mtongnz/ESP8266_ArtNetNode_v2/schematics/convert_max485_to_pix.png

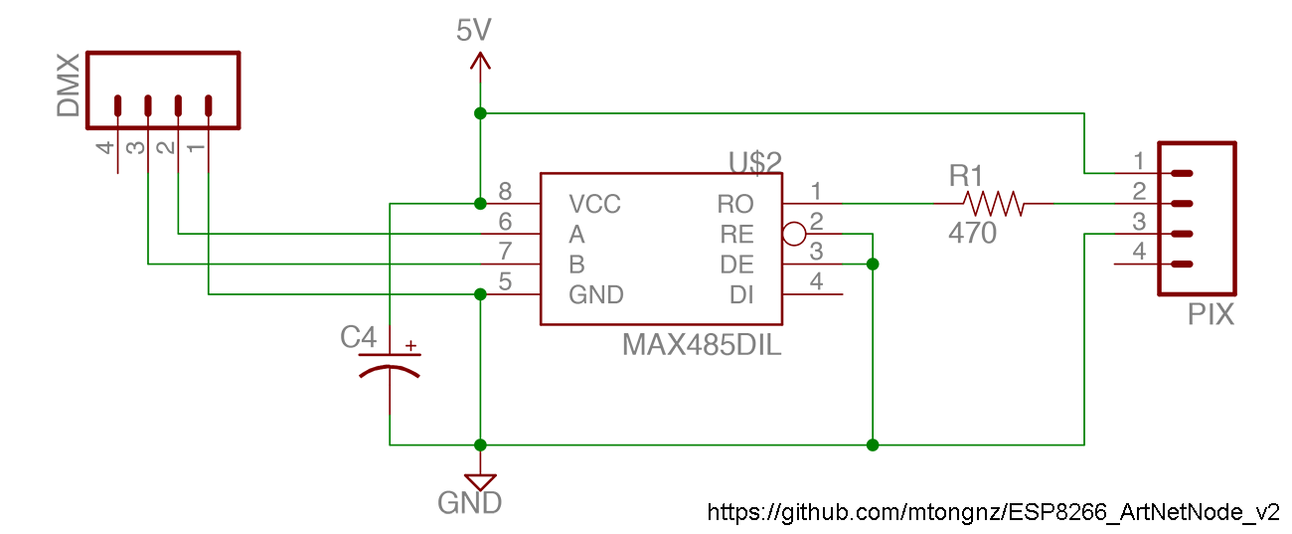
schematics/convert_max485_to_pix.png
