mtongnz/ESP8266_ArtNetNode_v2/schematics/esp_Artnet_RDM_isolated_v2.jpg

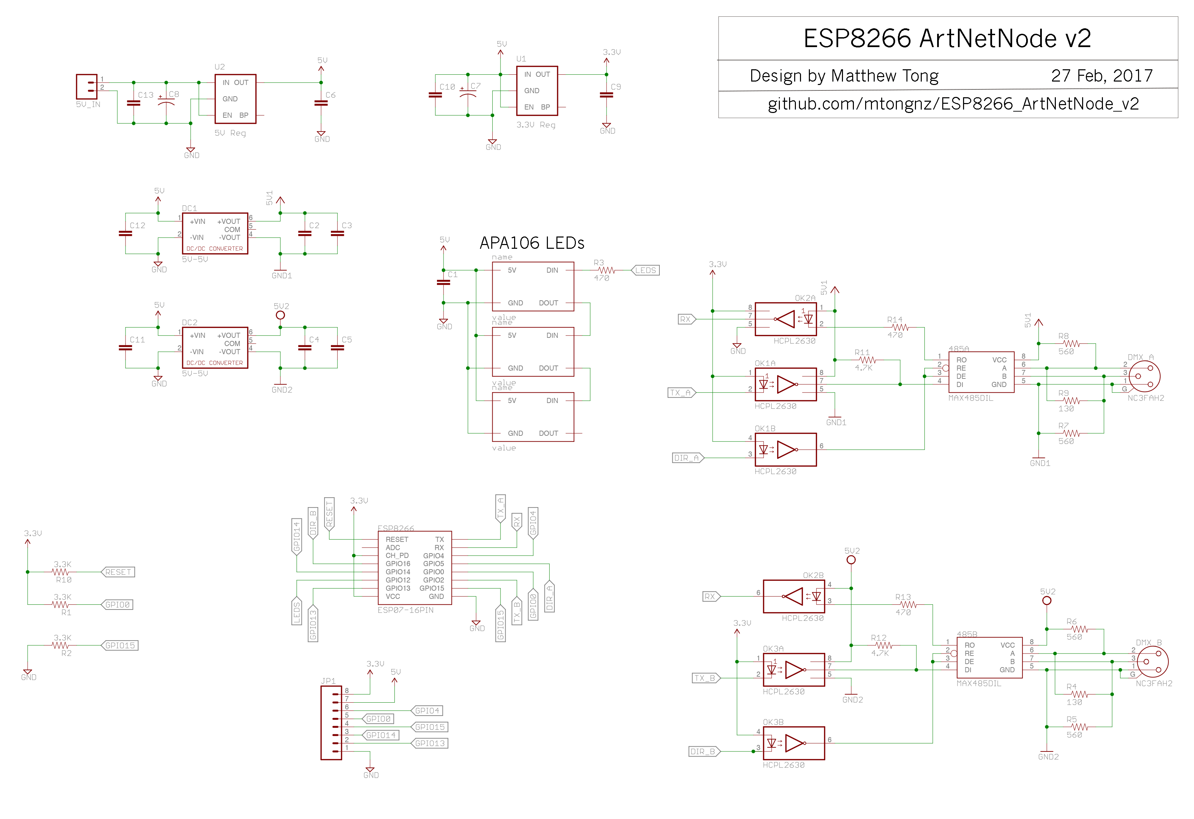
schematics/esp_Artnet_RDM_isolated_v2.jpg
