mtongnz/ESP8266_ArtNetNode_v2/schematics/node_dmx_and_pix_v2.png

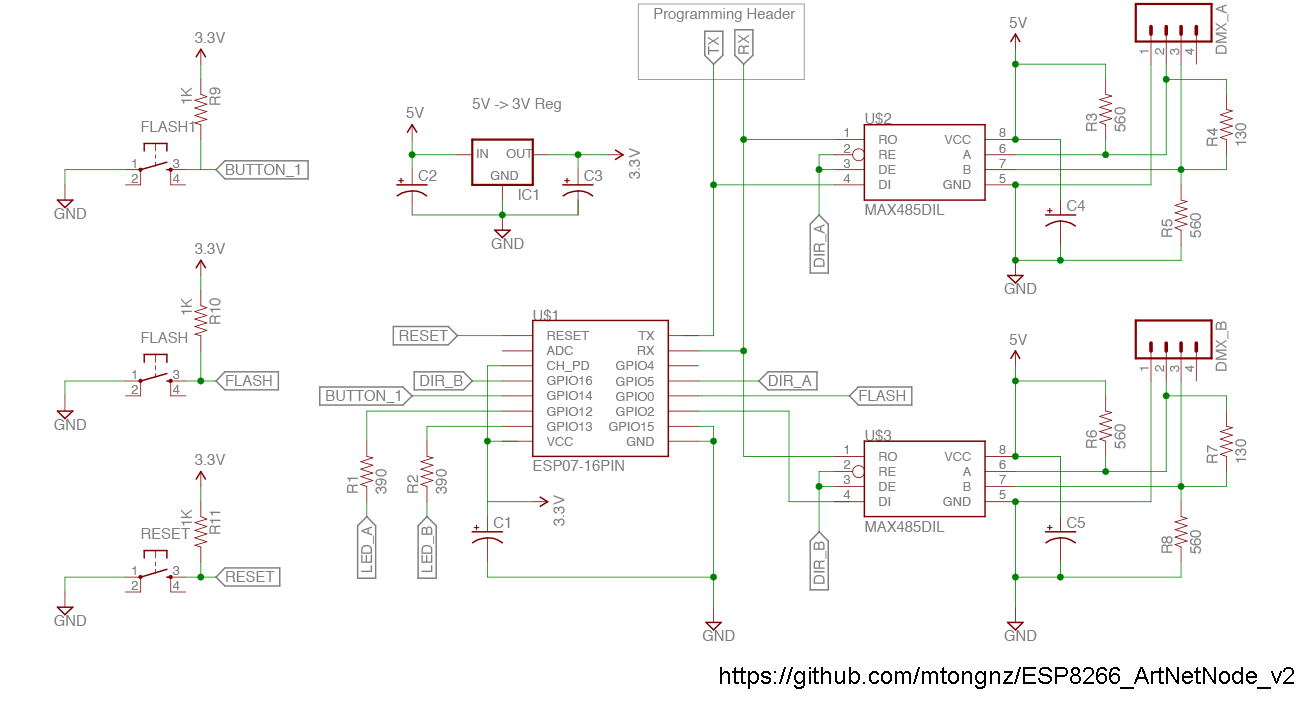
schematics/node_dmx_and_pix_v2.png
