mtongnz/ESP8266_ArtNetNode_v2/schematics/node_pix_only_v2.png

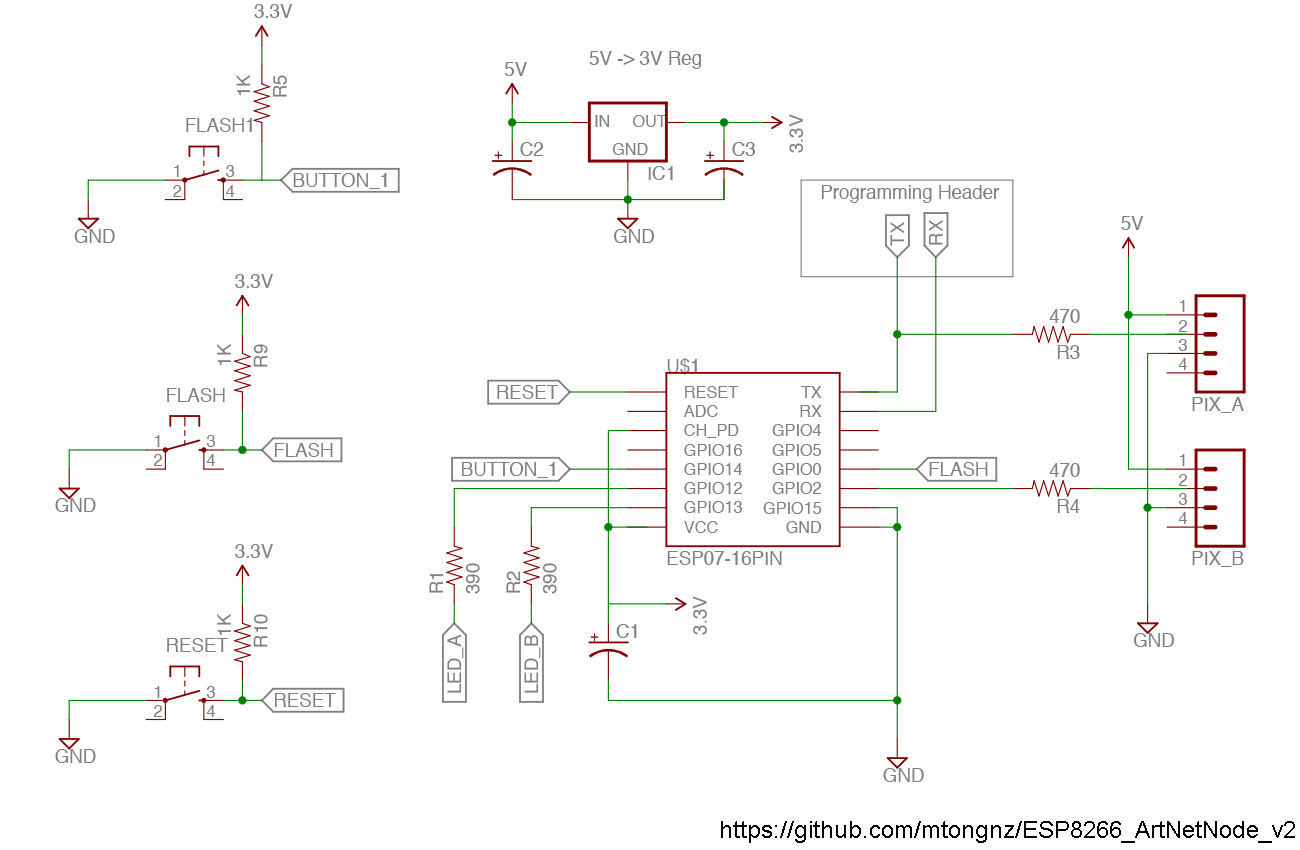
schematics/node_pix_only_v2.png
