mtongnz/ESP8266_ArtNetNode_v2/(threads)

Thread 1 (2017-02-01):

RDM Stops after discovery

mtongnz, 2017-02-01:
I've found an issue where the RDM stops during or after discovery if DMX is present.

The cause of this appears to be a faulty timer interrupt.  I'll hopefully have it fixed shortly.

mtongnz, 2017-02-01:
Hopefully this is now fixed.  Let me know

mtongnz, 2017-02-03:
beta1c should fix this issue

Closed 2017-02-08.

Thread 3 (2017-02-01):

Occasional reboot ~10 seconds after start

mtongnz, 2017-02-01:
Normally sorts itself out after a second boot.

I have put a temporary fix of forcing the device to boot a second time.  This isn't ideal and wastes about 5-10 seconds but it seems to fix the issue.

mtongnz, 2017-02-03:
beta1c should fix this issue

Closed 2017-02-08.

Thread 6 (2017-02-01):

RDM issues when DMX data sent

mtongnz, 2017-02-01:
It seems that DMX Workshop loses its RDM data when artDMX is sent to the device.

I think this may be because I am broadcasting RDM replies.  I will try unicasting the replies to see if it fixes the issue.

mtongnz, 2017-02-03:
beta1c should fix this issue

Closed 2017-02-08.

Thread 8 (2017-02-04):

Feature request: ad-hoc

irpyc, 2017-02-04:
Hey Matt,

First of all, really great job!

For my use, which is more mobile (shootings), I'll love if it was possible to use it without the need of establishing a network first, and use it directly with a DMX/Artnet soft on a tablet.
Even using one device as AP with the others connecting to it seems not so reliable, since if the AP disconnect (like running out off battery), all the others will then start a network at the same time.

Do you think there is any way to use Artnet on ad-hoc mesh such this project does?
(working version) https://github.com/sfranzyshen/easyMesh
(original and dependencies) https://github.com/Coopdis
(new fork of it) https://gitlab.com/BlackEdder/painlessMesh/

This would simplify a lot the deployment, and even extend the range.
So I'm not sure if it's at all possible, my programming and networking skills are way to low...
This easymesh project use TCP while Artnet seems to use UDP (on top of TCP ?). And easymesh doesn't use the Arduino libraries, so I guess they will be no native UDP support in it.
Maybe the fact that all the node get the same IP adress could be a problem somehow, but if only one node send the "sendArtNetReply", and then all of them get the same Artnet signal back, why should it not work?

What do you think?
Thanks,
Kind regards

mtongnz, 2017-02-04:
The mesh network idea is a good one but I fear it would be extremely hard to implement and I don't know how good the performance would be. I haven't done any mesh networking with the esp yet.
As for using one device as an AP with other devices connected, this doesn't work due to a limitation in the esp core files which doesn't allow packets to be forwarded properly from one client to another. I haven't tried it with this project but spent weeks trying to get it to work on another one before giving up.
The devices shouldn't start a network when they disconnect unless you restart them. I will be making it so each unit had a unique ssid soon and also adding the ability to change the hotspot name and password.
How have you found the stability and performance a far? And do you have RDM fixtures? If so, is the RDM working as expected?
Thanks heaps for the feedback. Id's much appreciated

Thread 15 (2017-02-08):

WS2812 not working properly

mtongnz, 2017-02-08:
I've found that the ws2812 doesn't work properly when using different power supplies for the ESP and the pixel strip.

Try running the device with the same 5V supply you use for your strips.  Obviously don't put 5V direct into the ESP - use a 3.3V reg to drop it down.

This seems to only be an issue with a larger number of pixels.

Please leave some feedback if you experience this

mtongnz, 2017-02-11:
Currently testing some new timing at a slower rate.  If it works, I'll add an option to the web UI so you can have the fast aggressive timing or the slow stable timing.

It seems to only be an issue with longer strings of pixels

nanu-c, 2017-02-12:
I think the solution for that is in experience to connect the - pol of the two power supplies.
The ws2812 is really sensible in that case.
And other thing i experienced with long strips is the voltage drop on the signal channel. You can use pull-up resistors to solve that or don't use more than 1m of cable in between the end of the last stripe and the first of the next stripe...

mtongnz, 2017-02-12:
beta4a has slightly slower data rates to try to help with this.  Initial tests seem to show good results

kaeltaz, 2017-02-14:
Try this timing
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

mtongnz, 2017-02-19:
Beta5 has much more strict timings in use.

It's working flawlessly on my 150 pixels - a few more are on the slow boat from China thanks to a couple of generous donations I received.

Try it and let me know.

mtongnz, 2017-02-26:
#36 is the same issue as this.  I am closing this thread and we can discuss there

Closed 2017-02-26.

Thread 17 (2017-02-09):

First pix on 2 uni is blinking

kaeltaz, 2017-02-09:
First pix on 2 uni is blinking

https://www.youtube.com/watch?v=qbqkvZ2hWWU

mtongnz, 2017-02-11:
I believe this is related to this issue: #15

I am waiting on some new pixels to arrive (bought thanks to a couple of donations I've received) before I can fully test my fix.  At present I only have 150 pixels to test with :(

mtongnz, 2017-02-12:
I've released beta4a.  It has a slightly slower data rate which will hopefully fix this issue.  Please try and let me know

Alfiszcze, 2017-02-17:
I belive that it is universe problem because the same issue is with 1st pix on 3rd universe .
512 dmx /3 = 170 and leftover 2 slots from dmx universe.

mtongnz, 2017-02-19:
Please try beta5 and see if it's better

mtongnz, 2017-02-21:
OK.... I've actually found the cause of this.  It was nothing to do with timing - I was accidentally writing over the first 2 channels of uni 2 with channels 511 & 512 of the first uni.

beta5a should definitely fix this issue.  I've only got 150 pixels so please test and let me know.

Closed 2017-02-26.

Thread 21 (2017-02-12):

Feature request: Reset Esp01

kaeltaz, 2017-02-12:
Reset esp-01 turning it on 5 times for 5 seconds.

mtongnz, 2017-02-16:
This will be in beta5.  Just doing more tests on it before release.  Having issues with DMX output interfering with the LED pixel timings

mtongnz, 2017-02-19:
Now in beta 5.

Allow the esp8266 about 1-4 seconds to start, then reset it (or power cycle).  Do this at least 5 times to restore factory default settings.

Closed 2017-02-20.

Thread 22 (2017-02-13):

Web Ui

kaeltaz, 2017-02-13:
My suggestion on web ui

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

mtongnz, 2017-02-13:
Ability to add and select custom themes will be added once I implement SPIFFS for storing scenes

kaeltaz, 2017-02-13:
I thought about the main themes

mtongnz, 2017-02-27:
You can now upload your own themes to the device in beta5c.  Goto /style to upload a new theme or revert to the default.

If anyone comes up with some good themes, please send them to me.  I'd love to have a look

Wachenanggo, 2023-01-02:
> My suggestion on web ui
>
> 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

Where can i customize that web ui?? or app?

Thread 23 (2017-02-15):

WS2812 RGB is swapped to GRB

querex007, 2017-02-15:
WS2812B RGB is swapped to green red blue.
Most artnet software use the RGB sequence as default.

Guess this is only a minor fix.
Keep up the awesome work 🙈💪

mtongnz, 2017-02-16:
I'm aware of this.  I just change it in the sending software right now.

It's not a bug as such, more just that the pixels use GRB instead of RGB in their data sequence - I don't know why.

I plan to add support for different configs at some point shortly.

mtongnz, 2017-02-16:
That was my thoughts - it's extra processing that isn't really needed.  I may add it if it doesn't cost too much in overheads

mtongnz, 2017-02-20:
After some consideration and talking with a few others' I've decided that I won't be implementing this in the foreseeable future.

querex007, 2017-02-20:
I get the point...
But one more comment, just to discus the project to make it as best as possible :-)

In point of use, RGB is more common use in the light and sound business, so also more user friendly instead of GRB.
(Everything is RGB of CMY in the light business).
The majority of the users of this project will control this WS2812 in RGB instead of GRB.

I guess it's the best to implement everything as RGB.
And I confirm, add an additional config property on the web GUI is overkill.
For the minority of users who want to use the controller is combination with GRB over artnet, they can chance the config of there artnet control software.

kaeltaz, 2017-02-21:
WS2812 is GRB as invented manufacturer. Most control software (Chamsys, MA2, Vista, Avolites, freestyler, JinX, Madrix can be replaced GRB to RGB control. This is no problem.

querex007, 2017-02-21:
@kaeltaz / @mtongnz
It's strange 'the use of a product' (DMX / artnet channels) needs to be aligned to the internal datastream (arduino > WS2812)?
As the general use of the product is RGB in 99,99% of the time.

**This sounds like:**
When the (internal) communication from your car it's steering wheel is swapped (left = right, right = left) over the CAN-bus.
They should make the steering wheel also swapped for the end user (left = right, right = left)?
You got the point?

Update the head fixture in your light control software is no big deal (RGB > GRB), but no user friendly...
When you have a lot of WS2812 strips, it will be annoying. :smile:
The LED standard is RGB in DMX and artnet.

Erates, 2017-02-21:
+1, to follow the RGB standard as artnet/dmx color sequence

mtongnz, 2017-02-21:
As has been said above by a few others, any decent control software will have GRB ordering built in.  Instead of adding an RGB fixture, select the GRB.

I don't get why they made ws2812 GRB instead of RGB but we can't change it now.  I get that RGB is the standard (I've been a lighting tech for 20 years) but performance is more important than a feature that can be handled by the controller.

**Adding this setting will use valuable clock cycles during the incredibly time critical ws2812 output.**

Most libraries that implement this feature do it as assignment stage - ie. you set an LED colour and it swaps them around and stores it to the buffer.  As all the data is coming in one block from Artnet for this project, it would require an extra step of reordering that block.  It would be a time/resource consuming process.  As it can be done by the (far more powerful) lighting controller, I don't think it is worth it.

querex007, 2017-02-21:
@mtongnz
Thanks, for the more in depth description.
I thought there was already a configured mapping from artnet > ws2812 😄
I understand the technical issue with the valuable clock cycles, you are correct!

I'm an ex lighting tech (9 year active), but I'm stil using Chamsys for some smaller private projects / events :roll_eyes: I can't live anymore without DMX / artnet :rofl: (master-slave or a Christmas tree of random scrolling colors, oh boy!).

Chamsys doesn't have an "GRB" head in it's (generic) default library:
LED 7chan, LED AWUV, LED RGBAW, LED RGBA, LED RGBW, Led10bar, Led20bar, Led3bar, LED3ch, Led4bar, Led4by2, LED4ch, Led5bar, LEDDRGBS, LEDRGBCD, LEDRGBDS, LEDRGBDSM, LEDRGBMS, LEDRGBSD, LEDRGBWDS, LEDRing, LEDWhite

Duplicate the RGB head and swap the color sequence to is not an issue.
But my advice was to improve the project, to support general users (with less lighting desk knowledge).

mtongnz, 2017-02-21:
I haven't used Chamsys much but a quick search turned up this:
https://www.controlbooth.com/threads/magicq-rgb-grb.34803/
You should only have to change it once to make a new fixture, then just patch as many as you need.

I do appreciate the feedback and I had seriously looked into doing this.

The best way I could think to do it was to read the bytes in a different order when outputting - this would save a long for loop when receiving Artnet.  Unfortunately this would mean less time for interrupts to run during ws2812 output - this is needed for DMX in/out to function.  At present, I can only allow a 3ms interrupt in my DMX library or the ws2812 timings get screwed up.

When I release the source in a month or so, maybe someone can come up with a good solution.

kaeltaz, 2017-02-21:
@querex007  for sure?
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

kaeltaz, 2017-02-21:
I use chamsys for 5 years. I also tests the this Artnet and ws2812 :)

Closed 2017-02-26.

Thread 27 (2017-02-19):

Can't upload firmware again.

asm7100, 2017-02-19:
Hi
Grate job :-)

I install the firmware with the http://esp8266-webupdate.local works fine the first time.
Made a error in the setup, and can't connect to it again, so i try to do the reset (power of min 5 times) and The GPIO14 to GND at start up, nothing works.
Then i try http://esp8266-webupdate.local to upload the firmware again.
Now i only get a lot of "noice" on the com port, and no SSID to connect to??

Try it a loot of times, nothing works. If i upload anoter project it all works fine, but not with your firmware.

I'am using Wemos D1 Mini.

asm7100, 2017-02-19:
The firmware will not run at all, its like the setting is fuct up

asm7100, 2017-02-19:
Yes i will trye the new Wemos D2 bin now.

mtongnz, 2017-02-19:
Is it working?  Or at least running?

asm7100, 2017-02-19:
Thats works, but when i give it a ip address in the setup, like 192.168.3.100 and there is no GW address to set. I can't connect to it any more.

mtongnz, 2017-02-19:
Gateway isn't needed as we're not connecting to the internet.  Make sure you've set the subnet correctly.

Also, if you're trying to change the IP for hotspot mode, it won't work.  The IP in hotspot mode is always 2.0.0.1.

I haven't tested the static IP settings for a while.  I'll check them later to see they are working.

asm7100, 2017-02-19:
I have my local network with wifi, an i normel use 192.168.x.x
And my wifi router is at 192.168.0.1 where all my computers are on.
i like the ArtNetNote to be on 192.168.3.100 and forward.
Can't i connect to the setup / config page by using 192.168.3.100 ?

mtongnz, 2017-02-19:
Yeah you can but you'll need to setup some routing tables or static routes in your router. I'm not very good at this.

Easiest way would be to set your computer IP into the 192.168.3.x subnet.

asm7100, 2017-02-20:
Why not just add a gw i have 6 security cam, 3 computer, som tables, oure phones, NAS server, some other ESP devices printer and so on.

asm7100, 2017-02-20:
When will you release the code, so i can make it my self?

mtongnz, 2017-02-20:
Code release will be when I do the first non beta release.  I still have sACN support to add first.  I will look into adding gateway for the next beta also.
This will probably be a few weeks away yet.
I am closing this issue as the initial issue is closed - I will open a new one with the gateway feature request

Closed 2017-02-20.

Thread 29 (2017-02-20):

GPIO2 on Wemos D1 mini is not good.

asm7100, 2017-02-20:
GPIO2 on Wemos D1 mini is not good, it has a 10K pull up,
Maby use GPIO5, GPIO4, GPI016, GPIO12, GPIO13 or GPIO14
Or better let the user set op up for ports.
With other word it dosen't work on Wemos D1 mini,
Link to Wemos D1 mini https://www.wemos.cc/product/d1-mini.html

asm7100, 2017-02-20:
In you sch you are not using GPIO4 maby use that to Port B

mtongnz, 2017-02-20:
That's true but I use it for my scope for testing.  I'll add it as a compile option shortly

asm7100, 2017-02-20:
Then i will test it :-)

mtongnz, 2017-02-20:
Is this for TX_B?  I can't change that - it's in the ESP8266 hardware which pin it's on.  I thought it was for a direction pin...

Note that the Wemos pins are labelled similar to the NodeMCU pins - it's the wrong numbering from the ESP8266's point of view.  You should be using this:

TX (GPIO1) for DMX_TX_A
D4 (GPIO2) for DMX_TX_B
RX (GPIO3) for DMX_RX (both A & B)
D1 (GPIO5) for DMX_DIR_A
D0 (GPIO16) for DMX_DIR_B

mtongnz, 2017-02-20:
I've added this info to the readme

asm7100, 2017-02-20:
D4 (GPIO2) Has a 10K pullUp and a led on it, Not good, dosent work.

mtongnz, 2017-02-20:
This is a hardware limitation, not software. Unfortunately they've designed their hardware poorly. Changing this in software will break other features of my firmware. Maybe just remove the LED and resistor.

asm7100, 2017-02-20:
Way not just swap to pin's
In the readme filen
WEMOS: This is compiled for Wemos D1 and similar boards. It uses the 4M (3M SPIFFS) compiler option.
How about specifi you can only use Part A to (DMX) nothing more.

asm7100, 2017-02-20:
Way will it break other features in your firmware?

mtongnz, 2017-02-21:
I won't be adding this feature. This device is primarily fir dc and rdm. If you want both outputs to be ws2812 then remove the LED and resistor.

I plan to make a similar unit to this just for ws2812 output in the future with 4-8 outputs.

MikeCurrington, 2017-06-08:
As a follow-up to this bug, the D4 (gpio2) port on the Wemos D1 mini works fine as an output for DMX data.
Asm7100 is correct that there is an led on the same port but unless there is another library trying to control the led this is not an issue.
I tested using an official Wemos D1 mini.

Closed 2017-02-21.

Thread 30 (2017-02-20):

Wemos D1 mini

asm7100, 2017-02-20:
D4 (GPIO2) Has a 10K pullUp and a led on it, Not good, dosent work.
All led, full white on them.
Trying to use it with WS2812.

mtongnz, 2017-02-20:
This is a hardware limitation, not software. Unfortunately they've designed their hardware poorly. Changing this in software will break other features of my firmware. Maybe just remove the LED and resistor.
I've reopened the other issue so discuss there

Closed 2017-02-20.

Thread 31 (2017-02-20):

How do you connect the ESP01 modul, then i will test that.

asm7100, 2017-02-20:

kaeltaz, 2017-02-20:
Please read carefully README!!!. use pin tx, rx and GPIO2 to DIR

asm7100, 2017-02-21:
like to use it for rgb control :-)

kaeltaz, 2017-02-21:
TX. Use 100-500om resistor.

Closed 2017-02-21.

Thread 32 (2017-02-21):

OLED and Encoder

kaeltaz, 2017-02-21:
My proposition to use oled and encoder instead of button,led. Oled give more opportunities, info and change the settings.
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

kaeltaz, 2017-02-21:
oled is cheap, only costs $2.80 (AliExpress)

mtongnz, 2017-02-22:
I like this idea. Out would have to be interrupt driven.

I haven't worked with encoder wheels before.  Would the 2 pins provide a click button also?

kaeltaz, 2017-02-22:
2 pins for encoder
1 pin for click button

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

mtongnz, 2017-02-25:
I am curious how it would go having the oled running off gpio0 which is used a a flash enable pin

kaeltaz, 2017-02-26:
https://nathan.chantrell.net/20141230/wifi-mqtt-display-with-the-esp8266/

gravicapa19, 2017-10-24:
I used this library:
https://github.com/klarsys/esp8266-OLED
Thanks klarsys
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

Thread 36 (2017-02-23):

ws2812 flicker at random times

mtongnz, 2017-02-23:
This issue is caused by a WiFi/system interrupt causing a low of >5us to be sent to the ws2812 data line.  I am still trying to find a way to stop this interrupt.

In the mean time, I have made a work around by disabling all interrupts during ws2812 transmission.  This however doesn't work when using DMX as the DMX needs interrupts to function.

If you are only using ws2812 strings, ensure both ports are set to ws2812.  If you are using DMX & ws2812, you may experience flickers for runs of longer than about 150-200 pixels.

TheSeven, 2017-05-02:
Have you considered using the I2S hardware to drive WS2812 in the background instead of bitbanging it?
Have a look at https://github.com/TheSeven/esp8266firmware/tree/master/src/device/ws2811 for an example.
Some of that code was written by me (feel free to use that), but the I2S interface setup etc. was cherrypicked from random places all over the internet - not sure where exactly the idea originates from. It's been floating around for a while.
Once I get around to getting this project set up on physical hardware (sorry, I'm quite busy lately as well), I might have a go at implanting that into this project.

scamiv, 2018-03-20:
I needed multiple stripes per esp so I2S wasn't an option.

The reason for the flickering is an added 6µs by the wifi IRQ. However this wont be disabled by calling RSIL as it is managed by the NMI.
Therefore you also have to mask the non-maskable interrupt to get consistent timing.
Luckily some wise guys found out how: https://www.esp8266.com/viewtopic.php?f=9&t=3979&start=20
After some trial and error i got it to work, it a'int pretty yet but flicker free at last.
[https://gist.github.com/scamiv/b931b307afaead5a0f43e6eb2bc57e08](url)

Thread 41 (2017-02-28):

WDT Resets

mtongnz, 2017-02-28:
There seems to be an issue with the watch dog timer causing resets about 10 minutes into operation.  I haven't been able to track it down and it takes ages to fault find when I've gotta wait for it to happen.

If you are watching in DMX Workshop, you'll see this show up in the status field when the device resets.  The output will also freeze for about 10 seconds.

Anyone experiencing these, please post your settings and the counter from status in DMX Workshop so I can see if there is a pattern.

theudas, 2017-09-15:
Does it happen always or only using leds?

ammuller, 2017-09-26:
Could you please try my code, I don't get WDT resets.
The lights stop working after a while, a reset from the web interface fixes it.
https://github.com/ammuller/ESP8266_ArtNetNode_v2

ElToberino, 2017-12-03:
I'm using your really great software with Ws2812b Pixels on Port A and Port B. (about 900 pixels in total)

After a certain time (about 20-30 Minutes) my Pixels freeze. Wifi connection is still there, I can load the web interface. I found out, that the only way to get back to normal mode is powercycling to times **or** resetting via web interface two times. It's interesting that powercycling or resetting only one time doesn't help.

I also noticed that the period of time until freeze is in hotspot mode much shorter than in Wifi-Mode.

Hope, this experiences will help solving the problem. I like your software very much and would appreciate any solition of this problem.

rsototec, 2017-12-04:
Hi, I have the same issue. I am using the Adafruit HUZZAH ESP8266 Breakout.
Thanks for your attention.

De: ElToberino [mailto:notifications@github.com]
Enviado el: domingo, 03 de diciembre de 2017 01:01 p.m.
Para: mtongnz/ESP8266_ArtNetNode_v2 <ESP8266_ArtNetNode_v2@noreply.github.com>
CC: Subscribed <subscribed@noreply.github.com>
Asunto: Re: [mtongnz/ESP8266_ArtNetNode_v2] WDT Resets (#41)

I'm using your really great software with Ws2812b Pixels on Port A and Port B. (about 900 pixels in total)

After a certain time (about 20-30 Minutes) my Pixels freeze. Wifi connection is still there, I can load the web interface. I found out, that the only way to get back to normal mode is powercycling to times or resetting via web interface two times. It's interesting that powercycling or resetting only one time doesn't help.

I also noticed that the period of time until freeze is in hotspot mode much shorter than in Wifi-Mode.

Hope, this experiences will help solving the problem. I like your software very much and would appreciate any solition of this problem.

—
You are receiving this because you are subscribed to this thread.
Reply to this email directly, view it on GitHub<https://github.com/mtongnz/ESP8266_ArtNetNode_v2/issues/41#issuecomment-348805785>, or mute the thread<https://github.com/notifications/unsubscribe-auth/AdWfz3MXQX7fJwgxWJjIb0bgbHsdL0hAks5s8vAIgaJpZM4MOCp6>.

dddaniele, 2018-03-05:
Hi bro, this solutions fix the problem for me (firmware 1.2) test 4 times for 4hour every time:
In ESP8266_ArtNetNode_DMX.ino:
- Add  ESP.wdtFeed() at void loop() start
- Add a delay(15) after webServer.handleClient()
I found also another bug in library that inibite the dmx "strobo funcion"
Please tell me if this work for you

bombcheck, 2018-03-05:
Damn, overlook the most obvious thing. :)
Will give this a try tomorrow.

dddaniele, 2018-03-06:
I already tried only with ESP.wdtFeed() only but wdt reset comes back. I also tried a delay 10 and the problem persists.
Setting instead ESP.wdtFeed() and delay(15) i have not encountered problems with my par LEDs and moving heads.

Try to comment those lines on espDMX.cpp (in the library folder) (this cause stobo function and wdt reset issues)

// Output full universe (512 channels) once every x seconds
    //if (millis() > dmx->full_uni_time + DMX_FULL_UNI_TIMING) {
    //  dmx->full_uni_time = millis();
    //  dmx->state = DMX_FULL_UNI;

    //  // Status LED
    //  if (dmx->ledPin != DMX_NO_LED) {
    //    if (dmx->led_timer++ >= 2) {
    //      analogWrite(dmx->ledPin, dmx->ledIntensity);
    //      dmx->led_timer = 0;
    //    }else
    //      analogWrite(dmx->ledPin, 0);
    //  }
    //} else

bombcheck, 2018-03-06:
espDMX.cpp? Did not find this file in the libraries. And can not find the mentioned lines anywhere in the project.

bombcheck, 2018-03-06:
Adding a delay of 15 ruins timing at the end of my strip. Reducing the value and trying some other modifications. But the issue seems to persist. It just lasts longer then before prior to crash...

dddaniele, 2018-03-06:
i'm running SP8266_ArtNetNode_DMX firmware 1.2

bombcheck, 2018-03-06:
Ahhhh I see. But here we are discussing the "new" v2 firmware which has these issues too. :)

delay (5) seems to work for me: No updating issues. Keeps reseting sometimes, but I catch the reset reason and doing a ESP.restart if the watchdog or an exeption occured.

bombcheck, 2018-03-07:
It keeps crashing from time to time. Sometimes after minutes, sometimes after hours. I THINK it may be from some bad packets received or something and not from the WDT...

ElToberino, 2018-03-28:
Does the WDT/freeze issue also occur with the old version ArtNetNode v1.2.0?
I just want to set up a simple node, without pixel support, RDM etc. So v1.2.0 would be perfect for me, if there wasn't this problem.

scamiv, 2018-04-20:
Have you given my fork a try? It should fix some/most of the existing problems.
The current git version runs stable for a few hours in most cases, however there's still the issue of heap fragmentation.
I will make another push soon which switches the lib over to umm_malloc to counter this.

idtres, 2018-06-17:
@scamiv I will check out your fork.
Can you summarize what are the main changes, and for how long did you run the node without any reset/frozen outputs?

blackrockcitynv, 2018-07-09:
scamiv.. does this fix the LED freeze and rebooting issues?

codehackr, 2018-07-15:
i tried scamiv fork of this code in my case it only last 15 mins and hard freezes requiring a power cycle to get it up and running again.

blackrockcitynv, 2018-07-17:
I have done extensive research on this issue and tested code many many different ways and setups. Its 100% the wifi services getting slammed with data.. the wifi lifetime timer does not renew when data is being sent. If i stop data send the timer renews

blackrockcitynv, 2018-07-17:
I looks like anyone and everyone who has attempted to make an Artnet wifi node has ran into the same issue (i have tested nearly every artnet neopixel wifi code on github) all the same exact wifi lifetime timeout issue

parechiotto, 2018-11-27:
Hi all!
I don't know if the bug was resolved from someone.
I've try to add thi solution: https://community.blynk.cc/t/solved-esp8266-nodemc...
And for me it seems work!

So I add in setup()
ESP.wdtDisable();
ESP.wdtEnable(WDTO_8S);

and in and in loop()

ESP.wdtFeed();

krupaw2, 2018-12-10:
How much I got tired of this program, I'm a beginner and I thought I was doing something wrong.
Meanwhile, after installing the "Esppixelstick" all problems have disappeared - I highly recommend.

Furbean, 2020-06-14:
Hi Matthew,

**The issue is not a software glitch**, i've discovered your project today.
I use a esp8266 (WeMos D1 R1) with 300 leds W2812s, i have a 20 ampere power supply for the 5 volts. After 10 mn, the esp8266 seems to freeze and between 3 and 10 mn, lights start again the animation.

Since i've connected the esp8266 on my powered usb port, i don't have any problems. It works very well even with a lot of effect in Jinx!.

We must add a capacitor to protect cpu i think, i will check this week.

Thanks for you great work !!

Igor1976-light, 2020-06-14:
Hi Furbean,

do this, paste into setup ()

ESP.wdtDisable();
ESP.wdtEnable(WDTO_8S);

and in loop()

ESP.wdtFeed ();

and the problem should be resolved. At least it works for me.

And a 1000µF / 16V capacitor comes between ground and + in the power supply of the LEDs

diegoferrero446, 2020-06-22:
Sorry, none of the solutions provided is a definitive solution, the problem is in Store

Thread 42 (2017-03-02):

Sk6812 led pixels

Bensmall, 2017-03-02:
Hi is it possible to implement the use of sk6812 pixels (same as ws2812b but rgbw Insted of rgb) as you get exactly 128 pixels per 512 dmx channels as configured for ws2812b only uses 510 dmx channels for 170 pixel
Many thanks Ben

kaeltaz, 2017-03-02:
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

mtongnz, 2017-03-04:
Thanks @kaeltaz.  Donations are much appreciated and allow me to purchase more bits for testing.  I have actually received a couple of donations in the last few days which I've used to purchase a strip of RGBW SK2812 LEDs.

I'll try to get this implemented for the next beta release so it can get tested by everyone before the final release.  The hardest bit is going to be updating the Pixel FX engine - it was designed for RGB, not RGBW so may be a bit of a challenge but we'll see how it goes.

mtongnz, 2017-03-27:
Implementing this is not quite as simple as I'd hoped - mainly due to the Pixel FX code being a bit sloppy.  I'll be releasing the source soon with a couple of rewards up for grabs for people who fix a few of the issues.  This will be one of the issues with a reward - it'll be one of the prototype boards I'm working on.

Bensmall, 2017-04-08:
hi just having a think when using the code for controlling 8 universes of
pixels does that allow me to use the full 8 universes worth of channels or
is it just the 12 channels for pixel fx ? and could it be that with the
sk6812 it uses just 8 universes with of channels if the fx code being a bit
of a pain with the sk6812 ? many thanks Ben

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

Deadeye5589, 2017-10-01:
What are the current problems with the implementation of this feature? Still trouble with the fx code or is it the driver itself?

mtongnz, 2017-10-10:
The driver will just need the timings tweaked for it to work.  The FX code needs to be re-written a fair bit for it to work.  I haven't had time to play with the SK6812 strips yet so haven't seen how much will need to be done.  Feel free to have a play with ws2812Driver.cpp and see if you can get the timings working.

Bensmall, 2017-10-10:
Okay will give it a go just need some time off work to have a play lol

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

Deadeye5589, 2017-10-11:
Timing should not be that much of an issue, since they are very similar between WS and SK LEDs. For both WS and SK the timing deviation is +/- 0.15µs. If your program has a tighter tolerance there is a good chance to have the SK LED running without modifications to the timing.

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

Bensmall, 2017-10-11:
The only issue I had when using sk6812 on ws2812 timing is that when using
more than one universe of them the seconds one is 2 channels behind as 170
ws2812 pixels use 510 dmx channels and then the last 2 dmx channels are
skipped, but with sk6812 128 pixels use 512 dmx channels so when using more
than 128 pixels there is issues, all that needs doing really is to tell the
code to use all 512 channels per universe of artnet and output it as spi
data for the pixels :)

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

Deadeye5589, 2018-05-17:
Finally I found some time to look deeper into the code, figuring out that I need some feedback on how the code works to fully understand it.

A new drop down selection for the web interface was created quiet easily. Similar the SK6812 value in the p_type enumeration. As far as I can see this new value should be processed by JSON quiet fine without further modifications. My blocking point is the actual call of the ws2812 drivers. I cant figure out how the output is being generated. I found functions for setting pixels, but I can't find the spot where they are called inside the program. Else I would simply double the ws2812 class and modify it for the sk6812.
With my SK6812 strips I can't get any output from the current software. Therefore some timing modification seems necessary.

Deadeye5589, 2018-05-18:
Hmm Arduino is blocking any progress on this.
For some reasons the commented lines regarding the SK6812 will prevent the compilation of the project

void doStatusLedOutput() {
  uint8_t a[9] = {0, 0, 0, 0, 0, 0, 0, 0, 0};

  if (!statusLedsOff) {
    if (statusLedsDim) {
      for (uint8_t x = 0; x < 9; x++)
        a[x] = statusLedData[x] & STATUS_DIM;
    } else {
      for (uint8_t x = 0; x < 9; x++)
        a[x] = statusLedData[x];
    }
  }

  #ifdef STATUS_LED_MODE_APA106
    pixDriver.doAPA106(&a[0], STATUS_LED_PIN, 9);
  #endif

  #ifdef STATUS_LED_MODE_WS2812
    pixDriver.doPixel(&a[0], STATUS_LED_PIN, 9);
  #endif

// No more space available after this ????
//  #ifdef STATUS_LED_MODE_SK6812
//    skpixDriver.doPixel(&a[0], STATUS_LED_PIN, 9);
//  #endif

  // Tint LEDs red slightly - they'll be changed back before being displayed if no errors
  for (uint8_t x = 1; x < 9; x += 3)
    statusLedData[x] = 125;
}

void setStatusLed(uint8_t num, uint32_t col) {
  memcpy(&statusLedData[num*3], &col, 3);
}

The compiler error stated that the text' will not fit in region `iram1_0_seg but I don't see why this small change should use up all of the remaining resources. The original code only used 31% percent of the available program memory and 57% of dynamic memory.

Deadeye5589, 2018-05-25:
Good news,

both SK6812 and WS2812 LEDs are working with the same timings. So the only thing that must be realized is the channel mapping 3 for ws and 4 for sk.
Still I can't figure out why the chip should ran out of memory by adding a sk6812 class.

Thread 43 (2017-03-08):

Possible to get more than 2 LED outputs?

fjanicki, 2017-03-08:
Would it be possible to get more than 2 LED outputs? Is there any hardware restriction behind this limitation?

mtongnz, 2017-03-09:
Are you meaning status LEDs?  If so, I'm currently working on using ws2812 LEDs for status instead.  I'm just waiting on them & the prototype PCBs to arrive before I can test it.

If you're meaning Artnet controlled LED outputs, then you can actually run 1360 LEDs - 680 per output.  These are the WS2812 addressable LEDs, not a standard LED strip.

mtongnz, 2017-03-09:
Also, I plan to start on a device in a few months - once I've got this project working "finished" and released.
It will hopefully have 8x WS2812 outputs, each capable of running at least 680 LEDs.

Closed 2017-03-27.

Thread 44 (2017-03-10):

12 channel FX reset

jmb-dmx, 2017-03-10:
ESP8266 (wemos) reset 4 or 5 time when artnet send data in 12 Channel Fx mode.
If I close the artnet connection it don't reset !

I make other test with other kind of ESP8266...and software.

mtongnz, 2017-03-14:
I will look into this shortly.  Which firmware are you using and is it with one or both ports set to 12 channel mode?

jmb-dmx, 2017-03-15:
Hi !
The last you put on github and I test with the all config option ! And it reset

Envoyé de mon iPhone

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

jmb-dmx, 2017-03-15:
This is the reset !
Make test with Martin MPC / luminair & QLC on win/mac/Linux

Envoyé de mon iPhone

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

Thread 45 (2017-03-13):

Only first LED lights up

potentstudios, 2017-03-13:
The first led only lights up green, yellow or white. I've used the same wiring (with the exception of the data pin) as this project https://github.com/scottlawsonbc/audio-reactive-led-strip and the entire LED strip lights up fine. Here are links to my patch and output settings. Patch: http://i.imgur.com/Y52UMQs.png Output: http://i.imgur.com/C2sdALC.png. For some reason Jinx! doesn't automatically recognize the nodeMCU as an output device but Vista 2 does.

jmb-dmx, 2017-03-13:
You have load the wrong project for pixel ! This is only DMX output.
This is the good https://github.com/mtongnz/ESP8266_ArtNetNode_v2

potentstudios, 2017-03-13:
Ope! When using the "Web UI OTA from my previous project" method to update the firmware with the .bin file, the nodeMCU shows a solid red light after clicking update in the Web UI.

jmb-dmx, 2017-03-14:
I have same thing with Adafruit Feather..... No problem with wemos and esp07.

mtongnz, 2017-03-14:
So this is a web UI update issue rather than pixel output issue?

It is possible that they have a different flash chip size which has caused me issues in the past.  Check your flash size - how to here: https://www.instructables.com/id/ESP8266-Artnet-to-DMX/#step4

Hopefully your chips are a 1M flash size or higher.  When you compile the v1.2.0 firmware, ensure you select the 1M(256K SPIFFS) setting or there isn't enough room for OTA.

I have a nodeMCU which I use for my prototyping and it seems to work fine.  Let me know how you go.

potentstudios, 2017-03-15:
The firmware is working flawlessly! The red light just scared me a bit. The
red light goes away after I set up the settings in the Web GUI and then it
briefly is on while turning on the device. Other than that it works
flawlessly with Jinx! software and I couldn't be happier! One thing I have
noticed is there's a bit of lag but I can work around it for my
uses because I'm only using midi information from Reaper to control the
lights so I put the triggers a little early in the timeline so it's on
beat. Thank you so much for your help! I'm so glad I found your tutorial
and that you were gracious enough to answer all my questions! Thank you!!

-----------------------
*Lee McIntosh*
Web / Graphic Designer
Portfoleeo.com <http://portfoleeo.com/>

<http://i.imgur.com/Yeg7t.png?1> <http://i.imgur.com/Yeg7t.png?1>

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

mtongnz, 2017-03-27:
I'm glad you got everything working.  The source will be released soon so hopefully the lag can be minimized by the community :)

Closed 2017-03-27.

Thread 49 (2017-04-17):

Reset from dmx

Alfiszcze, 2017-04-17:
Hi ..
There sometimes are some problems with node in WS2812 mode. It freezes display but I can still access to the web administration. It looks like bufor overload or something like this. So there are 2 questions:
1. Is there way to flash esp with your firmware @ 160MHz, because this maybe fix the problem.
2. Is there posibility to implement remote reset within DMX signals??
ie. since DMX 511 and 512 channels aren't used within WS2812 mode, so when put on both of them full signal [ 255 ] for 5 seconds it will tell ESP to reboot. Because when it hangs the only way to make it work again is to log in into web admin and reboot node. This isn't very simple solution when playing from consolete without using computer and sending DMX signal to reset would be the easiest way I see...or maybe you have other idea ??

I hope you bought polish beer, as I wrote on paypal instead of led strips :)

mtongnz, 2017-04-19:
The issue you're experiencing is known: #41

It was annoying me having to constantly physically reset the device when the WDT issue would occur so I put a counter in the code - if it has a WDT reset a few times in a row, it'll stop all output and just allow web access.  I am offering a prize to the person who fixes this issue - source code is currently only available to people who have donated but will be publically released in about a week - you should've received a link via email.

As for a DMX reset, I hadn't thought to do that - it could be done fairly easily but when RGBW pixels are used, all 512 channels are used - not that I've implemented RGBW pixels yet.  I'm hoping that this issue will be fixed in the near future.

I'm closing this issue as it refers to issue #41

Thread 50 (2017-04-21):

Node keeps rebooting/reseting later setup corrupted

matajumotors, 2017-04-21:
Hi,
I am using NodeMCU clone board (esp8266 with CP2102).
Flashed V1 with arduino, upgraded to espArtnetNode_2.0.0_b5d.bin OTA.
It works for a while (30min? or leass) an then it starts to reboot randomly (strip stops and I see specific pattern as when it boots - some white LEDs and a green). Then it re-connects to AP and condinues.
I had connected arround 200 leds or 60 leds - this does not matter.

I did run artnetWIFI sketch next to it and that did not freeze or reboot, so I guess power would not be the issue.

After a several reboots, the setup gets corrupted - SSID/password and other settings and of course falls back to AP mode (where I was able to see the corrupted settings)

Have you seens something similar?
Note this is my 1st day playing with your code and esp8266.

P.S.
I seem to have kind of lost or dropped UDP packets. I run 3x nodesside by side and all of them stutter at the same time once in a while, i guess it is a router thing, could you please comment on this also.

BTW I was impressed by the web interface - good job!

mtongnz, 2017-05-13:
This is a known bug #41

There is a prize up for grabs for the person who fixes this :)

Thread 51 (2017-04-21):

small bug in web UI

matajumotors, 2017-04-21:
When changing output mode form DMX to WS2812B, page controls (universes, led count etc) are not displayed. They become visible only when "save settings is pressed".
Ignore if it has to be like this, but it would make sense to update relevant controls when new output mode is selected.

mtongnz, 2017-05-13:
This is a limitation of my webpage javascript and could be fixed fairly easily.

Pressing save sends all the settings to the ESP which replies then with all the current settings (now with led count....).  My javascript only updates the webpage when it receives these replies.  You could make it change the page when the mode is changed if desired.

Let me know how you go - I'd love to add this feature to the main code.

Thread 55 (2017-05-31):

Schematics differences with v1?

sinedied, 2017-05-31:
First, thanks for your project and sharing the instructions with it! 👍

I successfully made a simpler version based on your v1 schematics, using a nodemcu 1.0 board (with 3.3V everywhere) and a single dmx output. It works very well 😄

I looked into the v2 schematics, and saw that you added a bunch of resistors, could your explain why? If I only use it for DMX output, not pixels/RGB is it useful to move to the new design?

Thanks!

mtongnz, 2017-06-05:
The resistors are for DMX termination and are recommended for RDM.  I based my design on an Arduino shield design by Mat Hertel - he explains it here:  http://www.mathertel.de/Arduino/DMXShield.aspx

sinedied, 2017-06-05:
Thanks for the info!

Closed 2017-06-05.

Thread 59 (2017-07-02):

are necessary MAX485 for WS2812 Led Strip?

hamedmaleki1366, 2017-07-02:
hi all ,
sorry for my english.

i need only show Jinx Provided Data on LED Strip , Are Necessary to use from MAX485?

can i use from node_pix_only_v2.png Schema, with out PIX_B connections.

what's basic connection needed for this.

thank you.

4bWM1a0SGxov2IM4BHre, 2017-07-03:
Hi, no they are not. I'm running 300 odd led's from the 3.3v data pin on a NodeMCU. You are prob better posting to the Instructables forum btw.

https://www.instructables.com/id/Artnet-LED-Pixels-With-ESP8266/

Closed 2017-07-04.

Thread 60 (2017-08-24):

esp8266mod stalling

Rtvstudio, 2017-08-24:
esp8266mod  stalling  after enabling rdm on port B.

mtongnz, 2017-09-18:
I believe this may be the same issue as here: #41
I haven't been able to fix this yet

Thread 61 (2017-09-07):

Stand Alone mode not working

Vrejf, 2017-09-07:
Hi
I can't get the Stand Alone-mode working in v2.0.0 (beta 5g)
When connected to an existing wifi everything is working correctly.
In Stand Alone-mode, i can connect to the wifi, and the  status on Port A says "DMX output".
But when trying to control the fixture nothing happens.
Am I doing something wrong or do you think its a bug?
And I can not find Style tab I read about.

Thank you very much!

ScholliYT, 2017-09-17:
If I'm right you cant send data to it in Stand Alone. Only play saved scenes.

from espArtnetNode_2.0.0_b5g.ino line 10

> <p class=right>In normal mode, the hotspot will start after <i>delay</i> seconds if the main WiFi won't connect. If no users connect, the device will reset and attempt the main WiFi again. This feature is purely for changing settings and ArtNet data is ignored.<p class=right>Stand alone mode disables the primary WiFi connection and allows ArtNet data to be received via the hotspot connection.

mtongnz, 2017-09-18:
It should work.  Ensure that the stand alone mode box is checked.  Check your console/computer has the correct IP and subnet and that it is broadcasting/unicasting to the correct IP.  By default, the IP's for stand alone should be in the 2.0.0.0 range with a subnet of 255.0.0.0 and your control software should unicast to the ESPs IP or broadcast to 2.0.0.255 or 2.255.255.255

mtongnz, 2017-10-03:
@Vrejf Could you please confirm if you got this going or not.  If you have, please close this issue.  If not, try giving us a bit of info on your setup (what software, IP settings on the computer...)
Thanks

mtongnz, 2017-10-10:
Haven't heard back with confirmation of this issue so I'm assuming you've got it going.  Closing this issue

bombcheck, 2018-03-05:
Just tried stand-alone-mode: Attached wifi-usb-dongle to my pc, connected to the hotspot and activated hot spot mode: Totally freeze/crash: I can connect to the hot spot, but neither the web ui nor my led pixel are responding any more. Had to re-flash with data-wipe.

Closed 2017-10-10.

Thread 63 (2017-09-20):

Addressing

radlxau, 2017-09-20:
Hi I might be missing something but is there a way to change the start address when driving pixels for Example i would like to be able to drive a single pixel off it and have multiple devices on network but don't want to use seperate universes is this possible? If not is there anyway you could implement it?

Great software by the way well done works a treat

Thanks

Jesse

mtongnz, 2017-10-03:
You could use the FX mode but I haven't implemented an address offset feature.  You could add it if desired - I shouldn't think it'd be too difficult.

Thread 65 (2017-09-25):

Simple PWM output

amcdawes, 2017-09-25:
First off, this is an awesome tool and thank you for sharing it! I feel a bit silly raising an issue, but I'd suggest a cool feature that would be another output style of "simple PWM output". A specific pin run in PWM mode tied to a DMX channel would enable all sorts of clever uses (servo, a single simple LED, driving solid state relays to control big stuff on stage). I can think of half dozen uses in shows I've helped with over the years. I'll be using the LED-strip driver mode _a_lot_ but would use a basic PWM output even more. I'm happy to help implement something like this, but I haven't jumped far enough into the code to see how to do so. I have my own clunky script for artnet DMX to PWM but it's missing all the cool RDM, web UI and general awesomeness of what you have here.

mtongnz, 2017-10-03:
This shouldn't be too hard to implement.  Look at adding it in the DMX handling function.

Unfortunately, I haven't had much time to play with this code for quite a while and work is only getting busier.  Please do share when you've got some code though.

alienfive, 2017-11-25:
I just tried the ARtnet to DMX and it work's great!
Well done and cool project!

Since i'm modifying some 50W RGB-flooder to "DMX/ ART Net" it would be nice to have at least min. 3 PWM channels for each color one.
Since I'm not a super programer, I started to go through the code, but at the moment I'm not really familiar with it and have no idea how to start ;(
Maybe you have some ideas & hints?

thejacko12354, 2017-12-14:
OT!
@alienfive could you share how you did modify the flooder? I'm really interestet.

cpethica, 2018-01-16:
Amazing software, thanks for taking the time to develop this mtongnz. I needed a DMX to PWM feature for project so I've tweaked your code a bit and it seems to be working fine. I've only used 4 channels so far but I'm sure you could add more - code is here, line 348 for the relevant code:

https://github.com/cpethica/We-Are-Symphony/blob/master/espArtnetNode_PWM/espArtnetNode_PWM.ino

I have it running on WEMOS D1 mini - you need to be a bit careful about which pins you use. As a result I've commented out all the status LED pin code as this was interfering with things and I was running out of pins to use... My coding is pretty bad but hopefully this will be useful to someone.

jfs-de, 2018-01-17:
Hello Matthew, Friends,
I changed the 1.20 code of to outputting 3 PWM 1024Bit Values. Threw out everyting not needed ( DMX dependency, etc... ) Gamma correction included.
AP Password: !)&&JochenSchefe1

Have a look if You want

[ESP8266_ArtNetNode_DMX-120-b-pwm.zip](https://github.com/mtongnz/ESP8266_ArtNetNode_v2/files/1639245/ESP8266_ArtNetNode_DMX-120-b-pwm.zip)

alienfive, 2018-02-09:
Hello together,

Thanks @jfs-de  & @cpethica for providing your solutions!
At the moment i just had time to test the one from jfs-de and it works great!

Maybe it should be implemented also in the artnetnode !?

@thejacko12354  i will update the RGB-Flooder with 3x TPS61500 (constant current step up regulatr from TI) --> this ASIC is controlled with the PWM signal of the ESP ;)

scamiv, 2018-03-21:
Here's an alternate solution, DMX_TX_A/B are now on pin 5/4 but you can change that to your liking, i disabled the directional pins as those aren't needed by me.
The array pwmports defines alll gpio's which will be exposed to artnet. {16, 0, 2, 14, 12, 13, 15, 3, 1};

Those ports will be availible at universe 10, for net and subnet the values of portA will be used.
https://gist.github.com/scamiv/687dfa8e80645878399900fc2c694ee0

tohox, 2018-05-09:
@scamiv Nice work adding the PWM outputs and fixing some of the earlier version's problems!

I've tried your 2.0.0d (beta 5g) version on a Wemos D1 mini Pro and found that only PWM outputs appear to work at the moment. As soon as I send anything to a universe associated with the PORTA DMX output port the ESP freezes. I've tried changing the pins associated with the DMX ports back to what worked with @mtongnz  original version but it seems to have no effect. The Wemos still crashes as soon as I send something through the DMX out port.

Also, in order for your sketch to work I have to select the "Wemos D1 and R2 mini" board and specify 4M (3M spiffs) instead of the "Wemos D1 mini pro" with 16M (15M spiffs).

Any ideas?

Thanks,

vwvanfan, 2018-10-06:
Firstly thank you for this code. I've got it running and it's controlling my strips nicely via WS2812.
I've since tried all 3 of the offerings above to get PWM working instead of WS2812 or DMX, but i'm struggling. It's most definitely my fault - my knowledge is poor. The closest i've got is @jfs-de 's version, which I actually managed to get on to the Wemos (couldn't succesfully compile the other 2 - my fault for being dumb I know). My issue with @jfs-de 's version though is that I just can't join the access point. I'm entering the password you list "!)&&JochenSchefe1" but it just won't have it. Have tried uploading the code via arduino ide and also the firmware update method with the .bin but neither gets me any further.

I'm building some artnet connected lanterns (chinese paper lanterns) so i need all the pixels to be the same colour. I have 2 options - use WS2812 and modify the code so every pixel has the colour of pixel 1, which has its' address set in the usual way via the browser interface. Or get PWM working.

If i'm honest, I think I prefer the WS2812 version as it involves literally no external hardware, just the Wemos, a power supply (battery charging board) and the strip. Not against using PWM though if I can just get some of the offerings above working.
Could anybody help with either some modified WS2812 code or some assistance with PWM. A .bin that I can just update the Wemos with via @mtongnz 's firmware update utility in the browser would be incredible!
Thank you so much!

cpethica, 2018-10-08:
@vwvanfan

I have a PWM version that worked for me. I’ve added a binary here:  http://github.com/cpethica/We-Are-Symphony/tree/master/espArtnetNode_PWM

Been a while since I looked at this but if I can find a Wemos today I’ll test again.

If you use WS2812 why do you need to change the code to get all the lanterns the same colour? Can you not do this at the control end with your lighting software?

Thread 70 (2017-11-27):

MQTT support

donnib, 2017-11-27:
Hi,
I am planning to mount roughly 24meters of LED lights in the ceiling of a big room that's dual purpose, one for parties and one as office therefore i was thinking to use this soft to control them with artNet from my Mac for parties but otherwise i need to control them as normal light (to light up the room) so i was thinking that adding MQTT support inside this would let me control the brightness/color from my HomeAssistant system leading me to control the lights from a wall switch with Zigbee support. Has anybody thought about that? I mean the MQTT support and artNet could work at the same time. It's just who is last that controls them that wins, or you could change mode in the WebUI. What do you think ?

The only problem i see is that i hope there is enough space in the ESP8266 to add MQTT support side by side with artNet.

/donnib

ammuller, 2017-12-04:
What functions would you require over Mqtt?

lukas2511, 2017-12-05:
Being able to set channel states and reporting state on changes would be great.

There are a ton of MQTT brokers and libraries, and there is example code for basically every programming language, so this would make a great API to easily connect to an ArtNet or a physical DMX installation with custom code.

Also it would make it fairly easy to integrate into existing home automation software like openHAB and Home Assistant, as existing plugins could (with special configuration or minor modifications) just work.

But I have to say that I'm not sure if this might be a bit too much for one piece of software...
I like features, but I also like devices that have just one job and are working rock-solid.

ammuller, 2017-12-06:
Would you be intrested in a Version with only Mqtt and ws2812 as a start?

Giaitzoglou, 2017-12-29:
@anmuller Hi @anmuller do you have the mqtt version I just want to dimmer some lights using a dmx dimmer not any scenes just dim and brithness!
Any help will be appreciated
Thanks
Chris

Giaitzoglou, 2017-12-29:
@ammuller sorry autocorrect

mtongnz, 2018-01-23:
MQTT isn't a feature I plan on implementing.  I'm sure there are other projects out there which use this.   Feel free to take my code and make something new with it but I wouldn't bother with Artnet if you're using MQTT for commands

Closed 2018-01-23.

Thread 71 (2017-12-05):

According to the version and schema

vormy, 2017-12-05:
Hello. Would like to repeat your project to control light by DMX
Tell me if I use the scheme
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
I need to use the firmware
espArtnetNode_2.0.0_b5g.bin

If I use a different scheme
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
Then the firmware should take another
ESP8266_ArtNetNode_DMX_1.2.0.bin

Libraries are the same for both projects?

ElToberino, 2017-12-07:
As far is I see, there is no difference between the layouts concerning the software version.
The newer layout uses octocouplers and DC-DC converters; this is a little safer, but has nothing to do with software functionality. I use the newest software version with the former layout.

vormy, 2017-12-08:
but what about the LEDs? firmware different indication. With the new firmware v2 on the old scheme will not work LEDs?

ElToberino, 2017-12-09:
You're right. LED indication is different. "espArtnetNode_2.0.0_b5g.bin" uses only one ESP-Pin for a digital output to drive three APA106-LEDs as indicators. The former software versions used two ESP-Pins, each for a standard LED.
I didn't focus on that because I don't need the indication LEDs and so I leave GPIO12 and GPIO13 unconnected.

mtongnz, 2018-01-23:
The libraries are different on the V2 software.  I wrote the Artnet and DMX libraries from scratch for V2 to allow RDM functionality.
In terms of hardware, there are a couple of major changes.  As I added RDM, I needed to add a direction pin and the RX pins to allow receiving data.  I decided to change from single LEDs to APA106 to reduce the pin count and allow for full RGB status LEDs.  The final change, as stated above, is the addition of electrical and optical isolation of the DMX outputs - this isn't required but makes for a safer system if there is an issue (such as power spike) on one of the outputs.
In theory, the V2 software should work on the V1 hardware but as I no longer have any V1 hardware, I can't test this.  If you're building new hardware, I'd recommend using the new schema as your base design.

Closed 2018-01-23.

Thread 72 (2017-12-09):

include code

ririfonfon, 2017-12-09:
hello I would like to include your code in my project.
so I included the files: ws2812Driver.cpp. h and wsFX.cpp .h
then in my ino file I add:
#include "ws2812Driver.h"
#include "wsFX.h"
#define WS2812_ALLOW_INT_SINGLE false
#define WS2812_ALLOW_INT_DOUBLE false
int showType = 0;
bool pixDone = true;
ws2812Driver pixDriver;
pixPatterns pixFXA (0, & pixDriver);
then in void setup ():
  pixDriver.setStrip (0,14,12,1);
  pixDriver.allowInterruptSingle = WS2812_ALLOW_INT_SINGLE;
  pixDriver.allowInterruptDouble = WS2812_ALLOW_INT_DOUBLE;
  pixDriver.updateStrip (0,12,1);
  pixDriver.show ();
but does not it? as you can see setStrip (...
0 i think it's the port of ws2512Driver
14 (gpio 14 or d5) esp8266 ws data
12 the number of led
and 1 mode 12 channels

there is no doubt about the wifi the artnet etc ..
all this works very well on another pin I graduated a led drivers pwm 14bits (it works).

I did not see an init function, what did I forget about?

Closed 2018-02-08.

Thread 74 (2017-12-14):

nodeMCU not saving changes from web GUI.

potentstudios, 2017-12-14:
I've tried several times to change the settings and it seems to be finicky on what it saves. I'm using a setup of 10 MCUs and some have no issues while others won't save. Any thoughts?

lampenschakelen, 2018-01-28:
Hi potentstudios ,

You can try to erase the esp8266.

This fix the problem for me.

http://www.pratikpanda.com/completely-format-erase-esp8266-flash-memory/

potentstudios, 2018-01-28:
Thanks I'll try that!

bombcheck, 2018-03-12:
Maybe this part of the setup routine?
```
// Check if SPIFFS formatted
  if (SPIFFS.exists("/formatted.txt")) {
    SPIFFS.format();

    File f = SPIFFS.open("/formatted.txt", "w");
    f.print("Formatted");
    f.close();
  }
```

It should be more like this right?
```
// Check if SPIFFS formatted
  if (!SPIFFS.exists("/formatted.txt")) {
    SPIFFS.format();

    File f = SPIFFS.open("/formatted.txt", "w");
    f.print("Formatted");
    f.close();
  }
```

khastings1066, 2018-06-18:
The solution proposed by bombcheck worked for me with beta5g.
Currently SPIFFS is wiped every time the system restarts.

potentstudios, 2018-06-27:
Has anyone else tested/confirmed bombcheck's fix?

Thread 76 (2017-12-18):

Weirdness with pixels and Jinx

ke4pjw, 2017-12-18:
I have found that I can configure my WS2811 strip and WS2812b pixels to work, only if I choose specific numbers of pixels to control. Otherwise it just gets weird. Sometimes the whole strip will flash like a rainbow. It will change colors when I change intensity. I have not put my probe on it to view the output. If I choose a certain number of pixels in the config, it will work correctly, but that number appears to be arbitrary.

I assume DMX channel 1 is the address of the first pixel when running in WS2812 mode.

BTW, wonderful project Matt! I was able to go from 0 to pixel control in about an hour. Very nice! Never touched the ESP8266 before this.

PS: I am running on the B port and both ports are configured for WS2812. The problem appears on both ports.

juli303, 2018-12-21:
I had the same problem. I'm no expert but apparently but apparently this happens because the signal voltage is only 3.3Vs so the LEDs sometimes don't register a HIGH signal as HIGH. Some people solved it by adding a capacitor between +5V and Ground and it works for me too.
Hope this solves your problem

madis25, 2018-12-21:
Guys... can you stop arguing about this and start to be clever (move your braincells or whatever).
I'm on the way to make this project, and have already fix idea how to solve this problem.
Shortly, start from power source. I connect ESP to the end of LED-chain. There's will be voltage drop anyway. Second, read spec of ESP and 8212, there's written that low output may be higher than real 0V. So, just add couple of resistors and 3,3V zener and that's all! Just moving real 0v little higher. Of course, calculation first, then testing. If the first 8212 LED will reciving information perfectly, ther everything else will work perfectly until the end of chain.
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

Thread 77 (2017-12-23):

Help with ip

Giaitzoglou, 2017-12-23:
Hi is it possible to tell if the art net esp can work in 192.168.1.0/24 networks ?
Or only 2.0.0.1 networks and also in you new firmware you have at ports
Net and subnet can you please tell me how to configure it correctly ?
Thanks in advance
Chris

Giaitzoglou, 2017-12-23:
Also what I want is to just control my Dmx dimmer lights is there an easer way with just mqtt and dmx ?

hsiboy, 2017-12-26:
Hi,

You may want to reconsider the 2.0.0.0/8 address that the ESP8266 uses for its own IP when running in "hotspot" mode.

1. This IP range is routable over the public internet.
2. Many security products will block this IP range.

Please consider using a non public internet routable, private IP address range.

Giaitzoglou, 2017-12-29:
So you say that the Artnet protocol will work in a 192.168.1.0/24 network . I want to use node red to control an dmx dimmer but I can’t make it work ! And I thought because the network is that and in the art net node I used the up of the dmx esp say for example 192.168.1.28.

Giaitzoglou, 2017-12-29:
@hsiboy

mtongnz, 2018-01-23:
@hsiboy The 2.0.0.0 (or 10.0.0.0) range is specified by the Artnet standard.  The network shouldn't really be connected to the internet and in stand alone hot spot mode, it is impossible to connect to the internet anyway.  I'll be leaving this as is but feel free to change it if you want.\

@Giaitzoglou The IP can be changed in the web gui to anything you want.  Provided you have all your devices in the same range and there's nothing blocking your packets, Artnet should work in any IP range.

hsiboy, 2018-01-24:
@mtongnz yeah, i think the 2.0.0.0 became the standard back when that IP address wasn't publicly routed on the internet and the 10.0.0.0 network has always been designated private, so that's a good choice.

But, its your project 👍

mtongnz, 2018-01-25:
@hsiboy The reason for using the 2.0.0.0 range in the Artnet protocol is simple - each device manufactured should come with its own unique IP.  From the official Artnet spec:

> By default an Art-Net product will factory start using a Class A IP address scheme.   This allows Art-Net products to communicate directly and without the need for
a DHCP server to be connected to the network.

> The use of Class A addressing is allowed within a closed network. It is important to
ensure that Art-Net data is not routed onto the Internet.
Products implementing Art-Net should default to the Primary IP address of 2.?.?.?.

Using a range such as 192.168.0.x would limit this to 255 devices which isn't very many.  Read more Artnet here: https://en.wikipedia.org/wiki/Art-Net and here: https://artisticlicence.com/WebSiteMaster/User%20Guides/art-net.pdf

I've tried to follow the Artnet spec as closely as possible - hence the 2.0.0.0 range.

As for this range being routed over the internet, this isn't actually possible in hotspot mode as it has no wan connection.  In my opinion, a lighting network with Artnet running on it should be separated from a network with internet connectivity anyway, either by using separate switches or implementing vlans.

And finally, the IP can be changed via the web ui.  When connecting to wifi (not hotspot mode), the device defaults to using DHCP and so will get whatever IP is assigned by your switch/router.  Once again, you can override this in the web ui and set a static IP of your choosing.

You are more than welcome to change the default IP in the source config if so desired but I'd prefer to follow the Artnet spec on this and so wont be changing it.  In theory, I should give each device a unique IP based on my OEM code & an arbitrary device ID, but this would mean connecting to the web ui would be a pain as the IP would be different on every device.

I hope this clarifies my stance.

Closed 2018-01-23.

Thread 78 (2017-12-30):

Will this work with the ESP-32 chip

Capii1, 2017-12-30:
I have the beta5g running on an ESP-12E chip and it works just fine. (When using the precompiled bin files) Will it be ported over to the ESP-32 chip in the future and also have you figured out why the source code does not work when compiled. I've tried to make some minor adjustments to the source however when I compile the unedited and edited source files it does not output anything to the LEDs.

idtres, 2018-01-21:
hey you already ported all to esp32 ? There is another UART on esp32... its possible a 3 out artnet node ?
https://www.youtube.com/watch?v=GwShqW39jlE
plus there are several pin on esp32 por pwm

tinic, 2019-04-08:
It's totally possible to port this to esp32. I did a quick and ugly port here https://github.com/tinic/ESP8266_ArtNetNode_v2  for a ESP32-POE  module.

It'll take another few weeks to port over all features and clean up the code base but the original code base makes a great starting point. I found a few obvious bugs which will likely cause random crashers. One benefit of running recent gcc compilers is that they guard against that. Also, instead of using assembly to drive GPIOs, using SPI yields way better timing for WS2812 LEDs without any flicker.

LoneWalkerWolf, 2021-03-12:
Yeah, @tinic is totally right.
We just need to change some lines of code in the libraries, and BINGO, it's ESP32 capable.

idtres, 2021-03-12:
How many DMX outputs can ESP32 handle ? this will be a nice feature

LoneWalkerWolf, 2021-03-12:
Honestly, I have no idea. It has a tonne more pins, but I haven't tried any sort of DMX software on it yet.
I'll let you know how it goes when I try it out.

idtres, 2021-03-12:
btw check this out
https://hackaday.com/2019/05/07/lots-of-blinky-esp32-drives-20000-ws2812-leds/

DachsbauTV, 2021-03-12:
This would acutally be amazing because it would be one step closer to having support for the amazing M5StickCPlus, which would make an amazing wireless Art-Net receiver

idtres, 2021-03-12:
At the moment I am working with the WS5500 ethernet adapter + esp32, and it quite easy to do UDP packages...
It would be a nice alternative to avoid bottleneck and WiFi errors for critical applications like DMX ( well, its not reall critical, but its time sensitive ).
There should be a alternative to the DMX output library of the ESP32 to have more than 1 single output

LoneWalkerWolf, 2021-03-12:
Yeah, sounds good.
I'm trying one with the ENC20-something. I'll let you know how it goes.

Thread 80 (2018-01-19):

Problems with DMX input

NeforMalchik, 2018-01-19:
Problems with DMX input. When I switch to port A input, port B output, then from time to time there is a failure of the input dmix. That is, I give 1-60% and 2-80% of the channel when there is a sharp failure 1 channel becomes 0%, 2 channel 60% and return 1 = 60%, 2 = 80%. When in the DMX workshop I do not connect the output failures do not occur. What could be the problem asking for a bug fix?

mtongnz, 2018-02-08:
Not sure exactly what is causing this issue.  I'll look into it when I get time

Thread 81 (2018-01-19):

Matrix ledstrip using ws2812B Led strips.

lampenschakelen, 2018-01-19:
First of all thanks a lot for making ESP8266_ArtNetNode_v2.

How do i connect the Wemos d1 esp8266 to the ws2812b led strips? To GPIO 1 only (TX)   Can you explain the wiring? A bit more?

I like to make similar setup as in the video below.
https://www.youtube.com/watch?v=WXv9AU-MPBU

NodeMCU & Wemos | ESP8266 GPIO | Purpose
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

mtongnz, 2018-02-08:
All the info you've asked for is in the images you've attached.  Just connect everything according to the schematic above.  The first table tells you which wemos pins to use.

Thread 82 (2018-01-20):

Node freezes after several hours

idtres, 2018-01-20:
Hi, Im using a WemosD1, one output set to dmx another set to PixelStrips, and also a 3 strips for the status LED
It works amazing, super fast, no delay or flickering, but after several hours the node stops sending artnet data and wstrips data.
1 status LED goes Red, and the other 2 stop responding, but at the same time, I can ping the device and the webpage responds

not sure what the RED led means.

Im sending data using VVVV, I slowed down the output to 10 frames per seconds per universe, still same problem.

Please let me know what other test I can try to debug this.

I tested sending 1 universe only, (dmx) and it worked just fine for  5 hours.

querex007, 2018-01-21:
I guess this is a known issue of the project...

I found a quick work around:
When the node freezes (and still responding to ping and web GUI), you can send 2 reboot CURL's, which makes the node operating again...

CURL: -X POST -H "Content-Type: application/json" -d "@rebootAmbilight.txt" http://192.168.x.x/ajax

As a reboot only takes 2 or 3 seconds, you can schedule this curl on your notebook / computer every 15 minutes.

terrag42, 2018-02-19:
Is there a way to use one ESP8266 to do nothing but periodically issue curl commands to my other ESP units which are running?

idtres, 2018-06-17:
I have been using the node with 2 dmx output receiving data from Resolume for almost 4 hours
The only changes I made are feeding the watchdog on the main loop ( ESP.wdtFeed(); )and commenting all lines about neopixel for the status leds,,, for some reason ( well its more like a feeling, no tech reason ) there is something wrong with that. The node as DMX is way more stable than for Neopixels. Using 600 pixels on 1 output only, it freezes all the time in less than 15 minutes. Same node as dmx can last 2 hours with no problem. After disabling all the status neopixels declarations, I was able to run the node for 4 hours without any problem.

I wrote a script to log if the ping stops, but this did not work, may times the node did not reply ping,but still works just fine. I was about to write a vvvv patch to evaluate 2 nodes, one as input a second one as output, but I wont have any way to tell witch one fails, so I will be using dmx as artnet sender + a webcam + rgb fixture, to change color every 1 second, and evaluate using the webcam if the color is correct.

@mtongnz did you found any other tip regarding this ?

Thread 83 (2018-01-28):

MATRIX NOT WORKING WITH ESP8266_ArtNetNode_v2 AND WEMOS D1 PLEASE HELP ME OUT

lampenschakelen, 2018-01-28:
Hi Mtongz,

Thanks al lot for making the program with the esp8266.
I hope you can help me out. I don't get it to work with my wemos d1.

I connect led data pin to the TX pin on my wemos d1.
And i used the follow code:
https://pastecode.xyz/view/028e6939

I used the ws2812 led stip total of 13 by 13 = 169 leds.

i add some picutres of the setup.

I tested the setup with the folowing great program:
https://github.com/toblum/McLighting

When i press now on start output the color is going to white.
But it's not changing to the colors on JINX! Screen.

So there is communication from the JINX! software to the wemos d1 with the led strips. But it's not changing to the right matrix.

I hope somebody can help me out.
To fix it '

Best regards,
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

Lampen Schakelen

ElToberino, 2018-02-01:
Pixels only showing white light is a well known problem, which has been solved some months ago by a user commenting the instructable. If you're compiling the source code, you have to set the ESP-CPU frequency to 160 Mhz. Default frequency is 80 Mhz, but this causes the malfunction.
The other, more easier way is just flashing the precompiled .bin-file available in this github.

Closed 2018-02-08.

Thread 84 (2018-02-11):

Description of status LEDs

meelow, 2018-02-11:
Hi Mathew,

thanks for sharing this awesome project. I do want to use your code to upgrade my own transportable lighting project from using OSC as input to go for DMX.

I read and saw in the code that you now use the first the LEDs of the attached stripe to show the status of the ArtNetNode.
From my experience (having some problems getting everything up and running - probably mainly because of old EEPROM data) I could see that:
the third LED seems to be the 'hearbeat' (blinking green in my case)
The first two leds seem to reflect PortA and PortB status (if yellow) OR
show (WiFi?) connection problems (if red).

Could you either describe your logic between colors / LEDs or point out where to look in the code to understand what errors pop up?

That would be a very good addition to the (pretty good) readme.

Let me know if i can support in writing a 'status-led' guide...

Thanks

Milo

mtongnz, 2018-02-17:
I haven't put much thought into the status LEDs yet.  It was more a proof of concept prior to me designing and ordering the PCBs.  I plan to make it much easier to set desired colours for each status.

Here's what it is for now:
Status LED:
    PINK - startup
    GREEN flashing - heartbeat
    RED flashing - nodeError isn't empty. generally caused by a WDT reset (the string will send over artnet)

Port A&B LEDs:
    CYAN - DMX input received and sent to artnet
    GREEN - DMX received from artnet - port in WS2812 mode
    BLUE - DMX received from artnet - port in DMX or RDM mode

The colours can be tuned using the definitions at the top of the sketch.  I haven't really thought through this much so feel free to come up with some better ideas and share them here.  I also haven't tested using WS2812 status LEDs yet but it should work fine.

markusb, 2018-07-14:
Just a comment, I'just starting to play with it on a Wemos D1. Things are partially working (DMX yes, WS2812 no). I found the status LEDs a great help, as they show me that I have my WS2812 LEDs wired correctly. The status LEDs are a great feature to see what is working and what is not.

Just one question: It looks like the 1st three LEDs on port A are used for status. So am I supposed to have three additional LEDS on port A for status or with the status vanish, when I start to use the string for lighting ?

Thread 85 (2018-02-13):

3800 Pixel LED installation

terrag42, 2018-02-13:
I am building an LED installation using 3800 pixels. Are four ESP8266s suitable for such a task using your software? I've attached my proposed LED layout here:
[LED Tree Proposed Layout.pdf](https://github.com/mtongnz/ESP8266_ArtNetNode_v2/files/1721124/LED.Tree.Proposed.Layout.pdf)

mtongnz, 2018-02-17:
Yes and no.  It is definitely capable of doing this but my firmware is still a bit buggy.  It has a habit of locking up after running for 10-15 minutes - see #82 .  I am working on a fix and that is a work around for now.  No idea when/if this bug will get fixed as I have limited time for this project for now.

terrag42, 2018-02-19:
Thanks for the quick answer. I saw your answer from issue #82 "As a reboot only takes 2 or 3 seconds, you can schedule this curl on your notebook / computer every 15 minutes."
Is there a way to use another ESP8266 to do nothing but periodically issue these commands to my other four ESP units?

mtongnz, 2018-02-20:
That would definitely be doable and shouldn't be that hard but I'm not sure on the actual code that would be needed.  I'd say there's code somewhere on the net for constantly updating remote servers with data (such as sensors) which could be easily modified to do this.

bombcheck, 2018-02-21:
My personal experience is, that using wifi is quite unrealiable. On places, where many many active wifi networks are found (on a big Fair for example), it is quite hard to even get a few bytes through a wifi channel. And using many ESPs with many universes will produce a large UDP-flood which could even break down a "normal" network at home.

When reliability is a concern, I would prefer a solution with wired network, if possible.

Thread 87 (2018-03-03):

Normal LED

dddaniele, 2018-03-03:
HI, thanks for sharing and develope this project,
i need help to drive normal LED for status A&B (with old schematic)

Thanks

mtongnz, 2018-03-25:
In the main file, look for a function called doStatusLedOutput.  This is where the status LED output is done.  Feel free to change it as you see fit.

I've got it so you can use APA106 or WS2812 LEDs so you only need 1 output pin for all the status LEDs.

Don't forget to run normal LEDs, you'll need to setup the correct pins for output in the setup function.

Thread 89 (2018-03-05):

esp_Artnet_RDM_isolated_v2 partlist

FaGitt, 2018-03-05:
Hi,

I just started reading electronic schematics, so please be patient to me, if I'm too dump to find the right info.

What kind of caps are used or where can I find a partlist for the isolated one?
I just can find descriptions like C12 in the schematics...

I hope you can help me.

Thank you!

mtongnz, 2018-03-25:
I've put a BOM in the schematics folder.  The caps are all simply for power filtering so values aren't too important.

Closed 2018-08-03.

Thread 93 (2018-04-28):

Lines of code to change to D6?

Clanggedin, 2018-04-28:
I have a D1 Mini that I have loaded the sketch to. I can see that the app is connected to my wifi and I can ping the IP. I guess I have the pins set incorrectly as I have a helmet where my LEDS are connected to D6.  I changed the references to the pins pointing to pin 2 or D4 to D6 or pin 12, but I am still getting nothing and I have the output running in Jinx.

Which lines of code need to be changed to use pin 12 (D6) instead of 2 (D4)? I changed all the ones I could see, but I just get the blue LED on the board constantly lit and not my matrix.

I have not used the Wemos bin file, just the sketch. Do I need to change the code in the bin and then upload it through the app to SPIFFS to run correctly?

Thread 95 (2018-06-09):

Wifi not conecting and other Errors

GoMini-01, 2018-06-09:
My esp won't conect to my local WiFi anymore (it workt at one point but decidet to stop now).
The WiFi setings are corect since it workt earlyer...

With the V1 version which workt flawles previously (first install). Now it conects to wifi and works "fine" but the A port won't work only B runs corect. At one point i got it to run both ports but it the output flickert.

edit: got it working ... (but for how long...) after uptating from v1 to v2 by web ui (the other ways didnt work for me ) it did not want to accept the wifi setings and startet in hotspotmode ... anter completly powering it of and on it worked...

Hardware:
  AI-Tinkerer ESP 8266-12F
  MAX485

IDE options:

WeMos D1 R1
  4M(1M SPIFFS)
  80Mhz

Lichtspieler, 2019-06-17:
Hello,
I´ve the same problem.

Barabba11, 2020-01-31:
Hi, me too, I've found the solution and works, I used another project based on this one. Soon I'll tell how

Cysign, 2020-02-13:
@Barabba11: Why don't ya just tell now? I've finished my DMX PCB3 month ago....and couldn't manage to get it up and running in my network...

Barabba11, 2020-02-13:
Sorry I forgot to write here, I posted already the solution in next issue: https://github.com/mtongnz/ESP8266_ArtNetNode_v2/issues/124#issuecomment-584823019

Cysign, 2020-02-13:
Thanks ;)
I'll have a look at my setup ;)

Thread 96 (2018-06-17):

Concern about EEPROM burnout

idtres, 2018-06-17:
I am a little bit concern about the fact of writing the eeprom on every power cycle twice, eeprom have short life cycle, but nobody knows the exact count, some say 100.000 others say 10.000, if this second one is the case, and if I use a node every day, its 2 cycles per day, 14 a week, 56 per month, 672 per year, so we should be fine for 14 years?

still I think than we can avoid the writing of the eeprom using this library
"reset pin as input", its a clever use of the RTC memory instead of eeprom. If the reset pin was pressed twice in a shot timeframe, it will load the default values. I like this idea to avoid loading default settings by mistake if the node is on a non stable DC power supply.
https://github.com/datacute/DoubleResetDetector/

  if (drd.detectDoubleReset()) {
    pinMode(LED_BUILTIN, OUTPUT);
    Serial.println("Double Reset Detected");
    digitalWrite(LED_BUILTIN, LOW);
     bool resetDefaults = true;
     eepromSave();
     delay(1000);
// maybe a restart here
    }

Barabba11, 2020-01-28:
eprom has sense to be written only when we save datas by web interface..

Thread 100 (2018-08-02):

Pin usage clarification

TurtleForGaming, 2018-08-02:
So what are all the pins used for I understand that thre is two out outputs but there is no schematic using all the pin

TurtleForGaming, 2018-08-03:
Nevermind didn't see the schematic folder

Closed 2018-08-03.

Thread 102 (2018-08-16):

Flickering until number of pixels changed

fastfourier666, 2018-08-16:
Hi there! Great bit of software here, thanks!

I'm having a weird issue with 2.0.0_b5g, set to ESP-01 mode on an ESP-12 (512kB). Uploading from the Arduino IDE with 64k SPIFFS and 160MHz. I'm running a string of 40 WS2812s.

I get some pretty severe flickering/random colours when I first start up the ESP. If I change the number of pixels in the web interface and "save changes", it works perfectly until the next reboot.

fastfourier666, 2018-09-03:
Sorry for a previous mistake - I think I am actually using WS2811 as each RGB module has 18 LEDs in it, which would suggest the standalone chip (I can't see any of the circuitry though)

I found a couple of the delays in ws2812Driver.cpp are too short, at least too short for my setup. Here are the changes which worked for me:

Line 174: changed to 128 clock cycles
Line 184: changed to 67 clock cycles
Line 208: changed to 123 clock cycles

Closed 2018-09-04.

Thread 104 (2018-08-22):

anyone tried with glediator? (flickering problem)

vettorazi, 2018-08-22:
hey guys! amazing lib! but when i am using my nodemcu with ws2812 with glediator, i have a lot of random flickering.
anyone has a solution for it?

MarcoBoer, 2018-10-23:
Hello, maybe a little late but here's mine solution........put on top off script this......
#define FASTLED_INTERRUPT_RETRY_COUNT 0

it works for me......good luck

gabri94, 2018-10-26:
I have the same issue... Where should i put that line?

vettorazi, 2018-10-26:
I didnt figured out. :/
Jinx works perfectlly

Em sex, 26 de out de 2018 11:44, Gabriel <notifications@github.com>
escreveu:

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

Thread 105 (2018-09-13):

getting unstable when setting both A/B ports to WS2812

PanOdbytek, 2018-09-13:
Hey!
First of: big thanks for your work! It's amazing!

So i am using a NodeMcu v3 to run the ESP8266_ArtNetNeode_v2. When i choose the WS2812 mode in both A/B ports (and connect the led strips respectively to the TX and D4 pins), the board seems to go crazy, constantly loosing connection or restarting...

Both ports are set to output data for 680 pixels. When i set up only one port, everything works fine.

Is that a known issue? Or maybe i am missing something?

thanks!

eplatero, 2018-10-17:
I'm having the same issue, single channel works great, but when I put strips on the secondary port, the board seems to hate it.

ozett, 2019-02-18:
powersupply too _small_ ?

Thread 106 (2018-10-11):

Nodemcu Amica / Output not working

leitooop, 2018-10-11:
Hello, amazing work with the code, still the best out there.

I'm having this issue with Arduino compilation in Nodemcu amica, Seems to work, web server is up, can configure WI-Fi settings, but then it doesn't give any output
BUT
when i compile firmware "espArtnetNode_2.0.0_b5g_WEMOS" direct from web server it works like a charm and output problem is solved.

So i have 2 questions
1) which are the pins used as TX in that compilation ?
2) How it was compiled?

i Try as Nodemcu 1.0, Wemos D1... with 4M (3M SPIFFS) and with 1M (3M SPIFFS)

But im really missing something here and I think it's the wrong output pin but also try several output numbers and the only think that soesnt work is the TX output.

I want to modify the code to "turn off" every led as default when Nodemcu powers up, is preatty invasive the fulll white when you turn on a big pixel matrix and thats why i need to compile from arduino. Maybe can try to solve some other bugs.

Again, amazing work here, hope to hear from you or anyone who got the same problem

cheers

Thread 107 (2018-10-23):

arduinojson version mismatch

dhgreg, 2018-10-23:
It took me a while to find the issue with not being able to compile out of the box.
so I hope this helps some other poor soul.
error compiling
Arduinojson.h needs to be rolled back below 6.XXX.
in the Arduino IDE Sketch>Include Library>Manage Library>[search arduinoJson]>verison.......rollback to 5.13.3.

compile ;)

https://github.com/bblanchon/ArduinoJson/issues/756

jtthewoodworker, 2019-07-27:
Thanks dhgreg! You helped this poor soul!

Thread 108 (2018-10-26):

This is more of a request-

RCFilm, 2018-10-26:
I found this interesting board off aliexpress.
This board have the eps8266 onboard. its designed for use with any led strips.
It also has audio input to have LEDs dance to the music.
This is of course only with their little app. Its a beautiful designed board that seems to be ready to go to load up a ArtNet Firmware like yours.

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

[Link to board](https://www.aliexpress.com/item/BSOD-Music-Led-Controller-DC5-24V-Wireless-APP-Control-Compatible-RGB-RGBW-Led-Strip-Controlled-by/32905578988.html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,searchweb201602_5_10065_10068_10130_10890_5730315_318_10547_10546_319_10548_317_10545_10696_450_10084_10083_10618_452_535_534_5729215_10307_533_5025915_532_204_10059_10884_323_325_10887_100031_5728715_320_321_322_10103_448_449_5728415,searchweb201603_55,ppcSwitch_0&algo_expid=747f8cf1-299d-41da-b1f3-8bd97c96e6f2-1&algo_pvid=747f8cf1-299d-41da-b1f3-8bd97c96e6f2)

jelimoore, 2019-02-04:
I've wanted to build something like this for a while. Just a simple artnet based rgb strip controller. I'll probably fork this code and then add my own modifications to make it work with mosfets instead of ws2182s.

Thread 109 (2018-11-05):

BPM detection

Cysign, 2018-11-05:
As far as I kno that ESP2866 has an analog in.
As some Arduino projects for sound detection are based on the MSGEQ7 I wonder if a bpm-detection for stand-alone-mode would be possible.

If ArtNetNode might be able to save a programm adding a microphone and a MSGEQ7 to the ESP2866 might be the key for BPM-detection - which is the only thing I might miss on the ArtNetNode.

How difficult might the software-extension be?

ScholliYT, 2018-12-22:
This would be more of anohter project if I get your idea right. What you want is a DMX outputting device that has some BPM detection with microphone, right?

I did something similar with sofware sided bpm detection. So I'm just sending over the DMX data (what this project is for) and do the sound2light on my pc.

Cysign, 2018-12-26:
It's more like an externsion. I'd like to have stored scenes/chases which respond to BPM.
I wouldn't build it as an indepndent or a softwarebased system.

ulri-me, 2022-11-18:
The main problem you have is that bpm detection requires a constant polling of the ADC value coming in to check for the amplitude peaks in sound intensity.

This is not possible as the target hardware has a single core cpu only which stops the actual code execution constantly to perform the assember code and output actual byte data.

The additional question I have as well is this:
What would you do with this value?
You would also need to perform a full rewrite of the whole stand-alone output library, as you would have to calculate the correct output step based on elapsed time since program startup and the current bpm measured.

Cysign, 2023-01-08:
In my band room there is everything connected using DMX. So setting an animated colorsheme while jamming or listening to music, it could be synchronized to the ambient sound ;)

So on an dualcore ESP32 this might be possible, as it has two cores. Maybe I'll get into it one day...

Thread 110 (2018-11-19):

Not able to connect leds

paradoxon0001, 2018-11-19:
Hello I'm rather new to the microcontroller world and can't figure out where and how to connect the leds.
The esp is correctly configured and the leds are working on another arduino with some sample code.
I don't really understand the pin table wich was provided in the documentation, could somebody explain it to me? I've got a board similar to this one: https://www.gearbest.com/boards-shields/pp_315642.html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

LoneWalkerWolf, 2021-03-12:
Can you provide some more information on the errors you are receiving?
Are these the status LEDsor the PixelFX LEDs?
What pin is specified in the code?
Do you have the right LED type selected?

Thread 112 (2019-01-14):

A way to use this project with ethernet

mrv96, 2019-01-14:
Hi, in order to make the connection more stable, it could be added an option that enable the use of an ethernet interface. If wifi is not strictly necessary is better to use cables usually, and this project is very fine.

LoneWalkerWolf, 2021-03-12:
Ethernet is very difficult to do.
I have tried many times and failed. Maybe take a look at:
https://www.instructables.com/Arduino-Artnet-Node/

mrv96, 2021-03-13:
Maybe Jonas Arnold succeeded: https://github.com/JonasArnold/EthernetDmxNode_esp8266

bangadrum, 2021-04-06:
Does the project compile for ESP32 boards? If so then other ESP projects (WLED, ESPHome) have got ethernet working reliably on the ESP32 boards, which I'm led to understand is much simpler than ethernet for ESP8266 boards.

LoneWalkerWolf, 2022-05-07:
Just thought I would reopen this thread. We have developed an ethernet version of this project. You can purchase our version from our Tindie store. https://www.tindie.com/products/lonewalker/ethernet-artnet-dmx-node/

LoneWalkerWolf, 2022-05-07:
> Just thought I would reopen this thread. We have developed an ethernet version of this project. You can purchase our version from our Tindie store. https://www.tindie.com/products/lonewalker/ethernet-artnet-dmx-node/

We are expecting to release the source code early next year.

mrv96, 2023-05-03:
I found the repo (https://github.com/expanseElectronics/ethernetNodes), but source code is not included.
The same is for https://github.com/expanseElectronics/artnetnodes, where I found .bin but not the source code.

LoneWalkerWolf, 2023-05-05:
We've decided not to make the source code available online for our wireless nodes; you can, however, flash the `.bin` file to an ESP8266 and use our pinout doc located [here ](https://github.com/expanseElectronics/artnetnodes/blob/gen3/pinout.md)to wire up the MAX485. With our ethernet nodes, we can't release any binaries, as the MAC address of the ethernet IC is hardcoded into the code and would not work when flashing a different IC.

Please send me an email at [alexander@expanseelectronics.com](mailto:alexander@expanseelectronics.com), and we can send you the source code for our ethernet or wireless nodes.

Thread 113 (2019-03-28):

Ajax "ambiguous overload for 'operator~' (operand type is 'IPAddress')"

Hugo500A, 2019-03-28:
I get this error when trying to compile espArtnetNode_2.0.0_b5g.ino

What am I doing wrong?

In file included from C:\Users\Hugo\Documents\Arduino\espArtnetNode_2.0.0_b5g\espArtnetNode_2.0.0_b5g.ino:41:0:

C:\Users\Hugo\Documents\Arduino\libraries\espArtnetRDM/espArtNetRDM.h: In member function 'void esp8266ArtNetRDM::init(IPAddress, IPAddress, bool, uint16_t, uint16_t, uint8_t*)':

C:\Users\Hugo\Documents\Arduino\libraries\espArtnetRDM/espArtNetRDM.h:157:75: warning: deprecated conversion from string constant to 'char*' [-Wwrite-strings]

       init(ip, sub, dhcp, "espArtNetNode", "espArtNetNode", oem, esta, mac);

                                                                           ^

C:\Users\Hugo\Documents\Arduino\libraries\espArtnetRDM/espArtNetRDM.h:157:75: warning: deprecated conversion from string constant to 'char*' [-Wwrite-strings]

C:\Users\Hugo\Documents\Arduino\libraries\espArtnetRDM/espArtNetRDM.h: In member function 'void esp8266ArtNetRDM::init(uint16_t, uint16_t, uint8_t*)':

C:\Users\Hugo\Documents\Arduino\libraries\espArtnetRDM/espArtNetRDM.h:168:93: warning: deprecated conversion from string constant to 'char*' [-Wwrite-strings]

       init(INADDR_NONE, INADDR_NONE, false, "espArtNetNode", "espArtNetNode", oem, esta, mac);

                                                                                             ^

C:\Users\Hugo\Documents\Arduino\libraries\espArtnetRDM/espArtNetRDM.h:168:93: warning: deprecated conversion from string constant to 'char*' [-Wwrite-strings]

C:\Users\Hugo\Documents\Arduino\espArtnetNode_2.0.0_b5g\espArtnetNode_2.0.0_b5g.ino: In function 'void ipHandle()':

C:\Users\Hugo\Documents\Arduino\espArtnetNode_2.0.0_b5g\espArtnetNode_2.0.0_b5g.ino:480:59: warning: narrowing conversion of '((~(int)deviceSettings.StoreStruct::subnet.IPAddress::operator[](0)) | ((int)(deviceSettings.StoreStruct::ip.IPAddress::operator[](0) & deviceSettings.StoreStruct::subnet.IPAddress::operator[](0))))' from 'int' to 'uint8_t {aka unsigned char}' inside { } [-Wnarrowing]

     deviceSettings.broadcast = {~deviceSettings.subnet[0] | (deviceSettings.ip[0] & deviceSettings.subnet[0]), ~deviceSettings.subnet[1] | (deviceSettings.ip[1] & deviceSettings.subnet[1]), ~deviceSettings.subnet[2] | (deviceSettings.ip[2] & deviceSettings.subnet[2]), ~deviceSettings.subnet[3] | (deviceSettings.ip[3] & deviceSettings.subnet[3])};

                                                           ^

C:\Users\Hugo\Documents\Arduino\espArtnetNode_2.0.0_b5g\espArtnetNode_2.0.0_b5g.ino:480:138: warning: narrowing conversion of '((~(int)deviceSettings.StoreStruct::subnet.IPAddress::operator[](1)) | ((int)(deviceSettings.StoreStruct::ip.IPAddress::operator[](1) & deviceSettings.StoreStruct::subnet.IPAddress::operator[](1))))' from 'int' to 'uint8_t {aka unsigned char}' inside { } [-Wnarrowing]

     deviceSettings.broadcast = {~deviceSettings.subnet[0] | (deviceSettings.ip[0] & deviceSettings.subnet[0]), ~deviceSettings.subnet[1] | (deviceSettings.ip[1] & deviceSettings.subnet[1]), ~deviceSettings.subnet[2] | (deviceSettings.ip[2] & deviceSettings.subnet[2]), ~deviceSettings.subnet[3] | (deviceSettings.ip[3] & deviceSettings.subnet[3])};

                                                                                                                                          ^

C:\Users\Hugo\Documents\Arduino\espArtnetNode_2.0.0_b5g\espArtnetNode_2.0.0_b5g.ino:480:217: warning: narrowing conversion of '((~(int)deviceSettings.StoreStruct::subnet.IPAddress::operator[](2)) | ((int)(deviceSettings.StoreStruct::ip.IPAddress::operator[](2) & deviceSettings.StoreStruct::subnet.IPAddress::operator[](2))))' from 'int' to 'uint8_t {aka unsigned char}' inside { } [-Wnarrowing]

     deviceSettings.broadcast = {~deviceSettings.subnet[0] | (deviceSettings.ip[0] & deviceSettings.subnet[0]), ~deviceSettings.subnet[1] | (deviceSettings.ip[1] & deviceSettings.subnet[1]), ~deviceSettings.subnet[2] | (deviceSettings.ip[2] & deviceSettings.subnet[2]), ~deviceSettings.subnet[3] | (deviceSettings.ip[3] & deviceSettings.subnet[3])};

                                                                                                                                                                                                                         ^

C:\Users\Hugo\Documents\Arduino\espArtnetNode_2.0.0_b5g\espArtnetNode_2.0.0_b5g.ino:480:296: warning: narrowing conversion of '((~(int)deviceSettings.StoreStruct::subnet.IPAddress::operator[](3)) | ((int)(deviceSettings.StoreStruct::ip.IPAddress::operator[](3) & deviceSettings.StoreStruct::subnet.IPAddress::operator[](3))))' from 'int' to 'uint8_t {aka unsigned char}' inside { } [-Wnarrowing]

     deviceSettings.broadcast = {~deviceSettings.subnet[0] | (deviceSettings.ip[0] & deviceSettings.subnet[0]), ~deviceSettings.subnet[1] | (deviceSettings.ip[1] & deviceSettings.subnet[1]), ~deviceSettings.subnet[2] | (deviceSettings.ip[2] & deviceSettings.subnet[2]), ~deviceSettings.subnet[3] | (deviceSettings.ip[3] & deviceSettings.subnet[3])};

                                                                                                                                                                                                                                                                                                        ^

C:\Users\Hugo\Documents\Arduino\espArtnetNode_2.0.0_b5g\ajax.ino: In function 'bool ajaxSave(uint8_t, ArduinoJson::JsonObject&)':

ajax:101:55: error: ambiguous overload for 'operator~' (operand type is 'IPAddress')

       deviceSettings.broadcast = deviceSettings.ip | (~deviceSettings.subnet);

                                                       ^

C:\Users\Hugo\Documents\Arduino\espArtnetNode_2.0.0_b5g\ajax.ino:101:55: note: candidates are:

C:\Users\Hugo\Documents\Arduino\espArtnetNode_2.0.0_b5g\ajax.ino:101:55: note: operator~(uint32_t {aka unsigned int}) <built-in>

C:\Users\Hugo\Documents\Arduino\espArtnetNode_2.0.0_b5g\ajax.ino:101:55: note: operator~(u32_t {aka long unsigned int}) <built-in>

C:\Users\Hugo\Documents\Arduino\espArtnetNode_2.0.0_b5g\ajax.ino:101:55: note: operator~(int) <built-in>

C:\Users\Hugo\Documents\Arduino\espArtnetNode_2.0.0_b5g\startFunctions.ino: In function 'void artStart()':

C:\Users\Hugo\Documents\Arduino\espArtnetNode_2.0.0_b5g\startFunctions.ino:237:68: warning: deprecated conversion from string constant to 'char*' [-Wwrite-strings]

       artRDM.setNodeReport("OK: Device started", ARTNET_RC_POWER_OK);

                                                                    ^

C:\Users\Hugo\Documents\Arduino\espArtnetNode_2.0.0_b5g\startFunctions.ino:242:91: warning: deprecated conversion from string constant to 'char*' [-Wwrite-strings]

       artRDM.setNodeReport("ERROR: (HWDT) Unexpected device restart", ARTNET_RC_POWER_FAIL);

                                                                                           ^

C:\Users\Hugo\Documents\Arduino\espArtnetNode_2.0.0_b5g\startFunctions.ino:248:91: warning: deprecated conversion from string constant to 'char*' [-Wwrite-strings]

       artRDM.setNodeReport("ERROR: (EXCP) Unexpected device restart", ARTNET_RC_POWER_FAIL);

                                                                                           ^

C:\Users\Hugo\Documents\Arduino\espArtnetNode_2.0.0_b5g\startFunctions.ino:254:91: warning: deprecated conversion from string constant to 'char*' [-Wwrite-strings]

       artRDM.setNodeReport("ERROR: (SWDT) Unexpected device restart", ARTNET_RC_POWER_FAIL);

                                                                                           ^

C:\Users\Hugo\Documents\Arduino\espArtnetNode_2.0.0_b5g\startFunctions.ino: In function 'void wifiStart()':

C:\Users\Hugo\Documents\Arduino\espArtnetNode_2.0.0_b5g\startFunctions.ino:358:59: warning: narrowing conversion of '((~(int)deviceSettings.StoreStruct::subnet.IPAddress::operator[](0)) | ((int)(deviceSettings.StoreStruct::ip.IPAddress::operator[](0) & deviceSettings.StoreStruct::subnet.IPAddress::operator[](0))))' from 'int' to 'uint8_t {aka unsigned char}' inside { } [-Wnarrowing]

     deviceSettings.broadcast = {~deviceSettings.subnet[0] | (deviceSettings.ip[0] & deviceSettings.subnet[0]), ~deviceSettings.subnet[1] | (deviceSettings.ip[1] & deviceSettings.subnet[1]), ~deviceSettings.subnet[2] | (deviceSettings.ip[2] & deviceSettings.subnet[2]), ~deviceSettings.subnet[3] | (deviceSettings.ip[3] & deviceSettings.subnet[3])};

                                                           ^

C:\Users\Hugo\Documents\Arduino\espArtnetNode_2.0.0_b5g\startFunctions.ino:358:138: warning: narrowing conversion of '((~(int)deviceSettings.StoreStruct::subnet.IPAddress::operator[](1)) | ((int)(deviceSettings.StoreStruct::ip.IPAddress::operator[](1) & deviceSettings.StoreStruct::subnet.IPAddress::operator[](1))))' from 'int' to 'uint8_t {aka unsigned char}' inside { } [-Wnarrowing]

     deviceSettings.broadcast = {~deviceSettings.subnet[0] | (deviceSettings.ip[0] & deviceSettings.subnet[0]), ~deviceSettings.subnet[1] | (deviceSettings.ip[1] & deviceSettings.subnet[1]), ~deviceSettings.subnet[2] | (deviceSettings.ip[2] & deviceSettings.subnet[2]), ~deviceSettings.subnet[3] | (deviceSettings.ip[3] & deviceSettings.subnet[3])};

                                                                                                                                          ^

C:\Users\Hugo\Documents\Arduino\espArtnetNode_2.0.0_b5g\startFunctions.ino:358:217: warning: narrowing conversion of '((~(int)deviceSettings.StoreStruct::subnet.IPAddress::operator[](2)) | ((int)(deviceSettings.StoreStruct::ip.IPAddress::operator[](2) & deviceSettings.StoreStruct::subnet.IPAddress::operator[](2))))' from 'int' to 'uint8_t {aka unsigned char}' inside { } [-Wnarrowing]

     deviceSettings.broadcast = {~deviceSettings.subnet[0] | (deviceSettings.ip[0] & deviceSettings.subnet[0]), ~deviceSettings.subnet[1] | (deviceSettings.ip[1] & deviceSettings.subnet[1]), ~deviceSettings.subnet[2] | (deviceSettings.ip[2] & deviceSettings.subnet[2]), ~deviceSettings.subnet[3] | (deviceSettings.ip[3] & deviceSettings.subnet[3])};

                                                                                                                                                                                                                         ^

C:\Users\Hugo\Documents\Arduino\espArtnetNode_2.0.0_b5g\startFunctions.ino:358:296: warning: narrowing conversion of '((~(int)deviceSettings.StoreStruct::subnet.IPAddress::operator[](3)) | ((int)(deviceSettings.StoreStruct::ip.IPAddress::operator[](3) & deviceSettings.StoreStruct::subnet.IPAddress::operator[](3))))' from 'int' to 'uint8_t {aka unsigned char}' inside { } [-Wnarrowing]

     deviceSettings.broadcast = {~deviceSettings.subnet[0] | (deviceSettings.ip[0] & deviceSettings.subnet[0]), ~deviceSettings.subnet[1] | (deviceSettings.ip[1] & deviceSettings.subnet[1]), ~deviceSettings.subnet[2] | (deviceSettings.ip[2] & deviceSettings.subnet[2]), ~deviceSettings.subnet[3] | (deviceSettings.ip[3] & deviceSettings.subnet[3])};

                                                                                                                                                                                                                                                                                                        ^

C:\Users\Hugo\Documents\Arduino\espArtnetNode_2.0.0_b5g\startFunctions.ino:383:61: warning: narrowing conversion of '((~(int)deviceSettings.StoreStruct::subnet.IPAddress::operator[](0)) | ((int)(deviceSettings.StoreStruct::ip.IPAddress::operator[](0) & deviceSettings.StoreStruct::subnet.IPAddress::operator[](0))))' from 'int' to 'uint8_t {aka unsigned char}' inside { } [-Wnarrowing]

       deviceSettings.broadcast = {~deviceSettings.subnet[0] | (deviceSettings.ip[0] & deviceSettings.subnet[0]), ~deviceSettings.subnet[1] | (deviceSettings.ip[1] & deviceSettings.subnet[1]), ~deviceSettings.subnet[2] | (deviceSettings.ip[2] & deviceSettings.subnet[2]), ~deviceSettings.subnet[3] | (deviceSettings.ip[3] & deviceSettings.subnet[3])};

                                                             ^

C:\Users\Hugo\Documents\Arduino\espArtnetNode_2.0.0_b5g\startFunctions.ino:383:140: warning: narrowing conversion of '((~(int)deviceSettings.StoreStruct::subnet.IPAddress::operator[](1)) | ((int)(deviceSettings.StoreStruct::ip.IPAddress::operator[](1) & deviceSettings.StoreStruct::subnet.IPAddress::operator[](1))))' from 'int' to 'uint8_t {aka unsigned char}' inside { } [-Wnarrowing]

       deviceSettings.broadcast = {~deviceSettings.subnet[0] | (deviceSettings.ip[0] & deviceSettings.subnet[0]), ~deviceSettings.subnet[1] | (deviceSettings.ip[1] & deviceSettings.subnet[1]), ~deviceSettings.subnet[2] | (deviceSettings.ip[2] & deviceSettings.subnet[2]), ~deviceSettings.subnet[3] | (deviceSettings.ip[3] & deviceSettings.subnet[3])};

                                                                                                                                            ^

C:\Users\Hugo\Documents\Arduino\espArtnetNode_2.0.0_b5g\startFunctions.ino:383:219: warning: narrowing conversion of '((~(int)deviceSettings.StoreStruct::subnet.IPAddress::operator[](2)) | ((int)(deviceSettings.StoreStruct::ip.IPAddress::operator[](2) & deviceSettings.StoreStruct::subnet.IPAddress::operator[](2))))' from 'int' to 'uint8_t {aka unsigned char}' inside { } [-Wnarrowing]

       deviceSettings.broadcast = {~deviceSettings.subnet[0] | (deviceSettings.ip[0] & deviceSettings.subnet[0]), ~deviceSettings.subnet[1] | (deviceSettings.ip[1] & deviceSettings.subnet[1]), ~deviceSettings.subnet[2] | (deviceSettings.ip[2] & deviceSettings.subnet[2]), ~deviceSettings.subnet[3] | (deviceSettings.ip[3] & deviceSettings.subnet[3])};

                                                                                                                                                                                                                           ^

C:\Users\Hugo\Documents\Arduino\espArtnetNode_2.0.0_b5g\startFunctions.ino:383:298: warning: narrowing conversion of '((~(int)deviceSettings.StoreStruct::subnet.IPAddress::operator[](3)) | ((int)(deviceSettings.StoreStruct::ip.IPAddress::operator[](3) & deviceSettings.StoreStruct::subnet.IPAddress::operator[](3))))' from 'int' to 'uint8_t {aka unsigned char}' inside { } [-Wnarrowing]

       deviceSettings.broadcast = {~deviceSettings.subnet[0] | (deviceSettings.ip[0] & deviceSettings.subnet[0]), ~deviceSettings.subnet[1] | (deviceSettings.ip[1] & deviceSettings.subnet[1]), ~deviceSettings.subnet[2] | (deviceSettings.ip[2] & deviceSettings.subnet[2]), ~deviceSettings.subnet[3] | (deviceSettings.ip[3] & deviceSettings.subnet[3])};

                                                                                                                                                                                                                                                                                                          ^

exit status 1
ambiguous overload for 'operator~' (operand type is 'IPAddress')

nikanet, 2019-04-10:
The same error

nikanet, 2019-04-10:
I change in ajax.ino
line 101:
deviceSettings.broadcast = deviceSettings.ip | (~deviceSettings.subnet);

to:
deviceSettings.broadcast = uint32_t(deviceSettings.ip) | (~uint32_t(deviceSettings.subnet));

and compiling now Done. Tested on Wemos D1 mini.

Lutzion, 2020-04-16:
The error depends on the used expressif version. You have to use a version < 2.x.
You also have to use an ArduinoJson-version < 6.x.

As i work with VSCode and platformio the resulting platformio.ini is:

```
[env:d1_mini]
platform = espressif8266@1.8.0   ; Version 2.4 not working, use the last 1.x version
board = d1_mini
board_build.f_cpu = 160000000L
;board_build.ld = eagle.flash.4m3m.ld
framework = arduino
build_flags = -ggdb3 ;-D ONE_PORT
lib_deps =
    64@5.13.4  ; ArduinoJson -> Version 5 needed, so use last 5.x version
```

LoneWalkerWolf, 2021-03-12:
Yes, @Lutzion is correct.
To quickly get rid of the errors. Use the following library versions:
- ESP8266 Version 2.4.1
- ArduinoJson Version 5.13.*

This works really well for a quick fix.

Thread 114 (2019-04-25):

jitter break and mab. DMX out not work properly

crazzypol, 2019-04-25:
How can you overcome jitter? devices do not perceive the parcel DMX, although the analyzer is fine. This project proposed a jitter solution, I can not apply it to yours. https://github.com/robertoostenveld/arduino/tree/master/esp8266_artnet_dmx512

Thread 115 (2019-05-23):

GPIO 14 button

spiku, 2019-05-23:
On the node_pix_only_v2 schematic,  you have button_1 tied to GPIO14. However, I cannot seem to locate the references to that in the code.

Did I miss something?

I'm trying to repurpose a number of boards that I built for another LED project, and swapping port A or B to GPIO14 would be the best option, however if something is already listening for input on GPIO14, I'll just bite the bullet and rework all 20 boards.

Thread 116 (2019-06-09):

Simple

bairlin, 2019-06-09:
Hi!

I need some help...
Is there any chance to get this library working to receive DMX input only? Or to get information how to use the library espDMX_RDM as a simple DMX node/receiver?

I have created a sketch for controlling WS2812B LEDs via DMX. So, a Wemos D1 mini is a DMX node/receiver which shall be controlled by a DMX Mixer. I´d like to receive a DMX signal and the Wemos to act as a node to control the WS2812B strip. I integrated the WS2812FX Library offering many effects. So, my work is close to the FX part within this project here.

This library here is the only library I found to be able to handle DMX receiving function...

Maybe there could be some example for sending DMX and also receiving DMX for integrating into own projects?

I hope there is a chance to get the receiving part running and I am looking forward to any help for this! Thank you so much in advance!!

julienhogert, 2019-07-11:
Same for me !
I'm trying to send DMX values with a Serial connection and don't find a way to receive it.
Looking at the code, I tried this:

`#include <espDMX_RDM.h>
#include <ecran_jh.h>

byte dmx[512];
byte* dataIn;

void setup() {
  ecran.setup();
  dmxA.begin();
  dmxA.dmxIn(true);
}

void print_s(int v){
  sprintf(ecran.buf, "REC. \n %i",v);
  ecran.print_buf();
  }

void loop() {
  dmxA.handler();
  dataIn = dmxA.getChans();
  dmx[0]=dataIn[0];
  print_s(dmx[0]);
}`
the print_s() function is just to print on a screen.
It doesn't work. How can I do? I use a Wemos D1 with a screen shield.
Thanks.
Julien

Thread 117 (2019-06-17):

Problem with DMX Input when Port B is active

heikoxxxx, 2019-06-17:
Hello, having the problem that DMX Input works well for me if i dont have any output on Port B.

But if i connect WS2812 Stripes on this output and send Data to this, or i configure Port B as DMX Output the Port A Input brings me a lot of incorrect values from my Light Controll to PC.

Is there any Bugix or do you think it is hardware related? Checked all Pullup resistors but dont seem that this is the Problem. Hope you can help me.

Thanks a lot :-)

heikoxxxx, 2019-06-20:
Does anyone have any idea to fix it?
Like that library because it has many possibilitys
and all other things are working very well.

Thread 119 (2019-09-22):

NodeMCU resets wifisettings after power cycle

Cysign, 2019-09-22:
Hey fellows,
I'm trying to get an NodeMCU running for this project.

Every time I power-cycle the device, it forgets the wifi settings and won't be able to connect to my wifi anymore :(

In the guy there's the green saves-button after I changed my wifi-settings.

What might be wrong with it?
Might the eeprom be broken?

Hitower78, 2020-04-05:
After get this devices Running, thats also my problem :-(

after save perhaps a reboot?

djkad, 2022-01-23:
Hi, I'm a developer. Although i'm new with nodemcu language, since i need a stable and minimal version of this project i'll put the hands inside this code.
I needn't the webserver and other stuff. I will hardcode the settings into variables so the logic will be:
Loop forever looking the xxxx ssid.
When found just connect using yyyy password and start to receive/send artnet traffic using hardcoded settings like ip,name,ssid,password and modes. I think that having a minimal solution could be the only road to find serious bugs

djkad, 2022-01-23:
I succesfully made a working project. I have only to debug and solve a reset situation (probably because the watchdog timer).
It's very fast because there is no webserver and it directly take the parameters at boot time without loading from filesystem. I was having problems with settings too but finally no more clear settings problems. By the way it's very easy to understand and it uses only 2 libraries: Wifi and Fastled. I directly read udp packet without having artnet libraries. When (or if) i find the solution of the reset i will share the code with mtongnz and you.

Cysign, 2022-01-23:
Sounds good! I still have the hardware next to my desk...but I gave up trying years ago :D

Thread 120 (2019-10-26):

Problem in uploading to module ESP8266 - 07

hadikhakbazpour, 2019-10-26:
Hello
I had a problem uploading the file
Here's a photo of the Arduino IDE Errors

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
In the headers the version used is clear
Please help me in programming

LoneWalkerWolf, 2021-03-12:
Can you give some more information? Maybe I can help.

Thread 122 (2019-12-11):

Which gpio For Pixel

LeonadLassen, 2019-12-11:
hey, with which gpio pin do I have to connect the to the ws2812 leds?

mtongnz, 2019-12-13:
There's a list of pins on the readme. You can use either TX pin

LeonadLassen, 2019-12-13:
Ah thank you.

Have a nice day

Thread 123 (2019-12-19):

DMX in for Fx

kefkevm, 2019-12-19:
Hi,

I want to use a DMX signal from a external controler to control ws2812 leds with the FX mode of the ESP Node.  How can i do this?

emilab, 2020-01-14:
Hello!!you already tried?

kefkevm, 2020-01-14:
Yes i tried

emilab, 2020-01-15:
🙄and??

emilab, 2020-01-16:
Hello @kefkevm

kefkevm, 2020-01-16:
It Does not work. Set the A connection to receive DMX. And B to ws2812 with 12 FX. But my leds wil not light up..

funkmasterfrank, 2021-11-22:
I have everything working except randomly it seems to lose connect to the other esp8266 with Wled installed. The first time it worked for 1 hour so I thought it was overheating in the case so I removed the cover and it worked for about 5 hours then it disconnected or something. Is there a sleep mode causing this issue? Any help would be appreciated

tapi35, 2022-12-04:
Hello, Funkmasterfrank, I want to create something liké you with two wemos.
First, stairville led foot 8 DMX connected on wemos with artnetnode / wireless transmission / wemos with wled / led strip.
Have you resolved this problem ? Do you use it ?  Is everything works fine  ?
Thanks

emilab, 2022-12-05:
Yes it's work fine!!

Ottenere Outlook per Android<https://aka.ms/AAb9ysg>
________________________________
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

tapi35, 2022-12-05:
I stopped working on my project since many years so I start like a newbie. I have flashed two wemos, One configurated to receive artnet with dmx out. It works great with My laptop and Qlc. The Other with Port A =>dmx in. Exactly the same connection ( TX GPIO). The XLR is in the output of my dmx pedal hardware. Normaly in qlc (plugin Artnet / Entry 192.168.1.127), I should see faders moving when I change my hardware presets ?
I don't understand what is wrong !!!!

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

If I've made a mistake, thanks a lot for your help !

tapi35, 2022-12-07:
If someone could help me, it will be great  ! I have spent 10 hours on it and I don't know if it's problem of connection or configuration.
My wled works fine with qlc on artnet but I don't know if my ArtnetNode works !
I post screenshots and schema.....Thanks a lot

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

kefkevm, 2022-12-08:
I think your broadcast address should be the ip of your router or pc where Qlc is running on. I am not sure about this, you have to try it...

Thread 124 (2020-01-04):

Any Project progress / new more stable FW version

Nostromo-star, 2020-01-04:
Hi,

this is still an interesting project and I wonder is there is still activity
respectively work on a more stable ESP8266 firmware that is addressing
the known bug in the code.

thanks guys,
TH

mrv96, 2020-02-03:
In my opinion the only relevant progress was done by JonasArnold in his fork, but he never make a pull request. I tried his firmware and for me its stability is better respect the original one.

I "forked" his repo and I fixed the compilation errors related to the latest ESP8266 core version. You can find my repo here: https://github.com/mrv96/ESP8266_ArtNetNode_v2/tree/JonasArnold

Barabba11, 2020-02-11:
For me it worked this, and this only after I tried many others.
It's based on the same project, so no evident differences:
https://github.com/bombcheck/ESP8266_ArtNet-LED-DMX-Node

mrv96, 2020-02-11:
@Barabba11 why is the project that you linked better? Which are the differences with respect the original one?

Barabba11, 2020-02-11:
Simply, it works :) one week past and a bit hard to remember, what I can say:
the port A don't produce any output on port TX0 (the other yes), only port B outputs, but probably it has a jitter problem. I was never able to see any reaction on fixtures from port B.
The bombcheck I connected to port A and don't test the port B, so I can't say if the problem was only that the TX pin was not outputing

djkad, 2022-01-23:
Hi, I'm a developer. Although i'm new with nodemcu language, since i need a stable and minimal version of this project i'll put the hands inside this code.
I needn't the webserver and other stuff. I will hardcode the settings into variables so the logic will be:
Loop forever looking the xxxx ssid.
When found just connect using yyyy password and start to receive/send artnet traffic using hardcoded settings like ip,name,ssid,password and modes. I think that having a minimal solution could be the only road to find serious bugs

Thread 126 (2020-03-15):

Problem for flashing code with d1 mini

tapi35, 2020-03-15:
Hello,
I want to use d1 mini for this code for connecting dmx and ws2812. I don't succeed in using arduino IDE. I have flash "espArtnetNode_2.0.0_b5g_WEMOS.bin"  with ESP.Easy.Flasher.  I have the web interface on hotspot mode, I configure my ssid with password but when I turn off the d1, all the parameters are cancelled. That's the first problem.
Is it possible to use arduino IDE directly with the d1 mini connected via usb ?
I have test with a lot of configuration : put LOLIN(WEMOS) d1 r2 and mini, flash size 4M(3M SPIFFS), cpu in 160Mhz. I have test with blink, it's ok but with the espArtnetNode2.0.0-b5g, message wifistart was not declare on this scope".
I don't use level shifter for the moment, is it a problem ?
Sorry for all those questions but I' m totally lost.  Thanks a lot for your help

muxlux, 2020-03-15:
I had a similar experience with D1 Mini until flashing an earlier version https://github.com/mtongnz/ESP8266_ArtNetNode_DMX.git
I was then able to upgrade/update to ESP8266_ArtNetNode_v2 through Web UI OTA

tapi35, 2020-03-16:
Thanks a lot ! it works. It's write on the description but I didn't notice it.

muxlux, 2020-03-16:
glad it's working!
i connected mine to a $2 max485 module & it's been working well with 90
channels (15 fixtures)
have fun!

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

Hitower78, 2020-03-31:
Hi ther!
i want to try it on a d1 mini, but i found a couple of Problems with the upload.
The V2 and V1 version doesnt load up.
i get errors in die IDE (1.8.12): StoreInit was not declared...
and several Artnet errors "sendartnetreplay" was not declared...

Did i miss a file or something? i am New to that stuff buw other projects are working fine :-)

muxlux, 2020-03-31:
are you compiling it for the 'LOLIN(WEMOS) D1 R2 & mini' board?

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

muxlux, 2020-04-02:
i'm using Arduino 1.8.10
may want to try downgrading

Hitower78, 2020-04-05:
Hallo zusammen
Hi there,

i use to flash the BIN, thats very easy with no complications!

in IDE the errors are still there... but the BIN is running now!

thanks

Hoizna, 2020-05-03:
is the dmx output of your nodes stucking (not smooth) ? mine is stucking

Hitower78, 2020-05-04:
i never check the DMX Out.
That would by the case in my next Project

muxlux, 2020-05-04:
i've experienced occasional signal interruptions
if it's real bad, you may have a & b on the rs485 module/transceiver

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

muxlux, 2020-05-04:
...reversed

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

Hoizna, 2020-05-04:
I have everything built like in the schematic... maybe it is because i am working with expensive nodes at work.
But i discovered, that the Old version: 1.2.0 is much more stable, and i don´t have problems with it. I don´t need the dmx in and the scene storage is also a good feature to have, so i will probably switch back again to the old version... Maybe the v2 gets more stable in some future code releases, than i will try again. Thanks for your help!

muxlux, 2020-05-04:
i had better stability with the older version too
i was only using one dmx output

it's a great project but there're quite a few open issues & the last commit
was two years ago
might be worth checking out some of the forks

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

Daniel091988, 2021-09-15:
Hello

I Flashed the Wemos D1 mini and connected it according one of the schematics.
but I dont get an DMX output. I am not sure if everything is connected correctly because the schematics is not for the wemos and i tried to connect it according the table. but its not working.
Can someone tell me how to connect the Wemos D1 mini correct with the Max 485 Module?

Thank you

muxlux, 2021-09-16:
Have you swapped tx & rx? I've made that mistake before.

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

Daniel091988, 2021-09-16:
I found the problem today. The dmx device did not recognize the dmx.
i used DMX Monitor app to send a signal via artnet and now it shows a signal.

Thread 127 (2020-03-25):

I'm almost there but....

tapi35, 2020-03-25:
Hello, Thanks for tjis great project ! I'm musician and I work on it for my show. It works for me with dmx hardware controlled by QLC+ with d1 mini. Now I build a 75X8 matrix of ws2812 using jinx. There's two days that I have a problem to solve ( image below)
I want to create 4 universes : 0,1,2,3 in jinx, each universe controls two lines of 75 pixels (so 150 per universe or 450 dmx channels). but in the panel, there is a hole of 20 pixel on the universe 1 and 2, the first : number 0 is ok
I don't understand. I 've tested with port a et port b, it's the same. I have also tested my strip directly and It seems to be ok. I have tested with many outpatch different, I have changed the number of pixel by universe in the port A settings.....the same.

is that somebody has already had this problem ?
Thank you
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

tapi35, 2020-03-27:
In fact, I realize there's only universe 0 which works. I have tested with just one line of leds and in jinx 3 pixel per universe on the same line. There's just the 3 pixels of the universe 0.
There is something that I don't understand !!!  Is it ok that 4 universes are on the same connection (tx for port A or d4 for port B  on the d1 mini ) ?

sparkescreative, 2021-05-09:
I seem to have the same problem. I have a gap of 20 pixels/LEDs between universes. Did you get it sorted?

Thread 128 (2020-03-30):

only one universe is working

tapi35, 2020-03-30:
I have made a new test with just one strip of 75 pixel with my d1 wemos
It works great with dmx on my devices but with strip led, only the 0 universe (0.1.2.3) works.
If I connect only one cable between the D4 pin and the the strip, I can address 4 universes on the same strip ? the d4 pin, alone, is able to drive the 4 universes, we are ok with that ?
I'm becoming crazy.....
Or do you think it could be a problem of flash? I have used ESP.Easy.Flasher, put "espArtnetNode_2.0.0_b5g_WEMOS" and it works (wifi, hotspot, dmx).
Is it possible that only the led library is missing ? When you flash directly, libraries are included ? I can't choose 160 MHz with this method so I don't know if it could change anything ?
I'm sorry for asking a lot of questions on this forum but I don't know anyone who could help me.  Thanks a lot  to those who can help me.

tapi35, 2020-04-04:
Nobody could help me ? or wants to help me ? Is it because my english is very bad or because I'm too stupid ( I already know that ;-) or I'm the first with this problem ?
I continue to test with differents settings in jinx and the hotspot mode. Perhaps, I will be lucky one day ....until it works.  it's just so frustating  rrrrrr

tapi35, 2020-04-09:
I try directly in qlc and only the universe 0 on TX works and the universe 4 on d4. Before, I've flashed a blank firmware to reset and reinstall a new one. Always the same problem.

OneDayFlie, 2020-04-18:
Same problem here... working with a 16x16 panel... and if i patch the second universe on it... i will miss a few rows and everything in the second universe is scrambled...

LoneWalkerWolf, 2021-03-12:
This is quite simply an issue with the ESP8266 chip itself.
It simply does not have enough RAM to store all the incoming ArtNet data it is receiving. So it just rewrites over the incoming data.
If you really want to control more than one universe at a time with WS2812 mode, it would be much easier to buy a cheap destripilizer from AliExpress and just use the node in DMX mode to connect to it.
Limited functionality, I know, but it's just a workaround until we can use the ESP32. I'm working on this now :)

Thread 129 (2020-03-30):

set correct flash properties in arduino IDE

mschlen, 2020-03-30:
Hello community,,

first thanks for this great project, I really love it. I only wanted to change a few things by myself in the code (like Wifi-Settings or add a few lines of code to my project needs).

I have a problem with the flashing of a ESP 8266 07S. The arduino IDE is working and compiling without a problem. Also flashing to the ESP does not throw an error. But the problem is, that the ESP does not open as a Wifi-device. If I am flashing the bin-file with the NODEMCU Firmware Programmer, it works without a problem Due to that, I can prove the hardware is working as expected. If using the compiled Arduino .bin file and try to flash it with the NODEMCU Firmware Programmer, the same issue appears - flashing is complete, but no Wifi Hotspot to log in.

So I think, there must be something wrong with my settings in the Arduino Tools. Please see attached file for my settings.

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

For me it is equal, if i compile in Arduino IDE and upload the bin. file with the NODEMCU Programmer, or directly compile and upload with the IDE. The essential would be, that it works.

I hope, anyone can tell me, if there is something wrong.

Thank you all,
Markus

mschlen, 2020-06-11:
So no comments?

LoneWalkerWolf, 2021-03-12:
Try change the following:
- CPU Frequency = 160Mhz
- Crystal Frequency = 26Mhz
- Flash Mode = DOUT
- Reset method = nodemcu

If none of that works, try changing the ESP8266 board library to version: 2.4.1
This also helps with compiling errors.
If you are still having problems, I am always happy to just send you a .bin file for you to flash manually.

Thread 132 (2021-01-23):

Crash/ wifi disconnect on RDM frame received

IS1024, 2021-01-23:
When any RDM frame is received via RX pin wifi disconnects until hardware reset.

Thread 136 (2021-05-16):

Status Leds

screwy39, 2021-05-16:
Hi, fantastic project.

Not so much an issue but possibly an addition unless I've over looked it or cant get it to work.
On the original version the 2 status leds did a combination of flashes depending wifi/dmx status. In V2 with my limited coding abilities I believe it looks like there are 2 options depending on which is uncommented. 1 the WS2812 or 2 the APA106. Is that right?
 I am using a esp8266 01 would it be possible to have a 3rd option of the single led flashing as in the original? I just want to use it as a basic dmx out.
Thanks

LoneWalkerWolf, 2023-04-22:
Feel free to email me at [alexander@expanseelectronics.com](mailto:alexander@expanseelectronics.com). I have unofficially taken over this project, as Matt seems to be offline / not contributing to this project anymore. We sell a version of this project on our website: [expanseelectronics.com](https://expanseelectronics.com), and you are free to send us an email at any time with any further questions.

**In response to your question: Unfortunately, there isn't a way to do this simply. You'd have to modify `espDMX_RDM.cpp` and `espDMX_RDM.h` to include this feature. In the V1 project, this is achieved using these lines of code:
```
      if (dmx->ledPin != DMX_NO_LED) {
        if (dmx->led_timer++ >= 2) {
          analogWrite(dmx->ledPin, dmx->ledIntensity);
          dmx->led_timer = 0;
        }else
          analogWrite(dmx->ledPin, 0);
      }
```
However, in this V2 version, these lines are omitted from the configuration file. You'd have to add these in manually and change a lot of code for this to work.

I hope this answers your question!

Thread 137 (2021-06-17):

The code reports an error in the editor

Tang-tzu-huan, 2021-06-17:
in the  ajax.ion's line 101

`deviceSettings.broadcast = deviceSettings.ip | (~deviceSettings.subnet);`

espArtnetNode_2.0.0_b5g\ajax.ino: In function 'bool ajaxSave(uint8_t, ArduinoJson::JsonObject&)':
ajax:101:55: error: ambiguous overload for 'operator~' (operand type is 'IPAddress')
espArtnetNode_2.0.0_b5g\ajax.ino:101:55: note: candidates are:
espArtnetNode_2.0.0_b5g\ajax.ino:101:55: note: operator~(uint32_t {aka unsigned int}) <built-in>
espArtnetNode_2.0.0_b5g\ajax.ino:101:55: note: operator~(u32_t {aka long unsigned int}) <built-in>
espArtnetNode_2.0.0_b5g\ajax.ino:101:55: note: operator~(int) <built-in>

exit status 1

ambiguous overload for 'operator~' (operand type is 'IPAddress')

stanelie, 2022-10-20:
Duplicate : https://github.com/mtongnz/ESP8266_ArtNetNode_v2/issues/113

Thread 138 (2021-11-21):

random glitches on DMX received data

antoniomechas, 2021-11-21:
Hello,
I'm using the library as a DMX receiver from an ENTTEC USB PRO.
It kind of works, but I get random values time to time, even when the values I'm sending stay stable without modification.

The relevant code I'm using:

`void setup()
{

  WiFiOff();

  dmxA.begin();
  dmxA.dmxIn(true);

  dmxA.setInputCallback(dmxIn);

  delay(1000);

} // setup

void dmxIn(uint16_t num) {
	// Double buffer switch
	//byte* tmp = dataIn;
	dataIn = dmxA.getChans();
	//dmxA.setBuffer(tmp);

	newDmxIn = true;
}

void loop() {

	//dmxA.handler();
	if (newDmxIn)
	{
		analogWrite(PIN_LASER, dataIn[1]);
		newDmxIn = false;
		lastDMX = millis();
		singleGreen();
	}

	if (millis() - lastDMX > 2000)
		singleRed();

	delay(1);

} // loop`

I get the laser glitching even when the value of the channel stays to 255.

If I put all the channels at the same value, it seems to get a bit more stable.

Any thoughts what could I test?

Thanks!
Antonio.

antoniomechas, 2021-11-21:
Digging a little bit more... it happens with the Lolin Wemos D1 pro... if I use a wemos D1 mini, the glitches dissapear.
I have no clue why it happens.
Antonio.

Thread 141 (2022-06-13):

Turn LEDs off on startup

MasterSmollett, 2022-06-13:
Hi! Fantastic work!

Is it possible to turn all led's (ws2812b) **off** on startup ? Or not turn them on ?

At the moment all led's turn white, I would like to avoid the power surge.

My cpp is a bit rusty, but I'm happy to do a PR if you point me in the right direction.

Thanks!

ulri-me, 2022-11-18:
Hi,

I have never worked with this lib and the WS2812b LEDs.

But have a look at this reddit discussion:
https://www.reddit.com/r/arduino/comments/d5yjmt/ws2812b_default_color_after_power_on/

The question is if the library does anything itself to start the LEDs with full white.

As far as I can see the only DMX output buffer initialisation with a default value is this line
https://github.com/mtongnz/ESP8266_ArtNetNode_v2/blob/4a1f803e6d3cd0946d18dc851ab2eeb200e828f4/libs/espDMX_RDM/espDMX_RDM.cpp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
which stores 0 as default value for a newly created DMX buffer.

And for the LED strip itself does this line
https://github.com/mtongnz/ESP8266_ArtNetNode_v2/blob/4a1f803e6d3cd0946d18dc851ab2eeb200e828f4/source/startFunctions.ino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
execute this function
https://github.com/mtongnz/ESP8266_ArtNetNode_v2/blob/4a1f803e6d3cd0946d18dc851ab2eeb200e828f4/source/ws2812Driver.cpp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
which also clears the buffer to 0's by calling this function
https://github.com/mtongnz/ESP8266_ArtNetNode_v2/blob/4a1f803e6d3cd0946d18dc851ab2eeb200e828f4/source/ws2812Driver.cpp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

ulri-me, 2022-11-18:
So I would assume you have to be faster with starting the output (or even start the output before powering up the LED strip) or get this capacitor trick from Reddit to work.

Thread 143 (2022-11-28):

Random Crashes

gmint, 2022-11-28:
I have two ESP8266 Node MCU devices. One of them is driving about 450 pixels out of one output and about 120 out of the second output. The second device is driving about 300 pixels out of one output. I am experiencing random hangs on both devices. Sometimes I can go hours without anything hanging, other times it will be 20 minutes. I've tried everything I can think of: e.g. increasing the size of the capacitors, making sure I have a very large, stable, and correctly calibrated power supply, making sure my LED strips have been power injected at the required points, making sure my wifi access point is located very close to the ESPs.

These are both being driven by ArtNet. I'd considered trying sACN, but have not done this yet. Are there any other tips or tricks that I might try to increase the stability?

madis25, 2023-03-20:
The same there. Was thinking that it may be router problem, but the same is with other routers. 4 ESP-s on table, turned on same time, working, then one by one falling down. Just power off works sometimes, most of the times getting hotspot mode. Really annoying to fill again all data :(

madis25, 2023-11-04:
But I remember that I made this priject first time in january 2019. Then I hadnt this kind of problems. Maybe libraries updated/changed or something?

517002650, 2023-12-27:
I have also encountered this problem. Controlling WS2812 will cause this problem, requiring two restarts to control the output of the DMA. It is normal

517002650, 2024-01-09:
> 但我记得我在 2019 年 1 月第一次做了这个 primeject。然后我就没有这种问题了。也许库更新/更改了什么？

Translation: Do you remember the library version at that time and do you have any impression?

Thread 145 (2023-04-01):

schematic for wemos d1 mini?

lesleylemmens, 2023-04-01:
hi,
is there a schematic for wemos d1 mini?
A fritzing schematic style would the best.
I can only find a schematic for a totaal dit 8266 solution

LoneWalkerWolf, 2023-04-22:
Feel free to email me at [alexander@expanseelectronics.com](mailto:alexander@expanseelectronics.com). I can definitely send you a schematic for a D1 mini.

In response to your other questions:
- The module you've linked, the side with `DI DE RE RO`, is the side for the ESP. The other side, which is labelled `GND A B VCC` is the side for DMX.
- In the schematic you've attached, the pixels are driven using the IO2 (for port B) and TX (for port 1). Be careful not to enable DMX output on these pins, however, as this could damage your WS2812B LEDs. I'd recommend using the `convert_max485_to_pix.png` schematic linked [here](https://github.com/mtongnz/ESP8266_ArtNetNode_v2/blob/master/schematics/convert_max485_to_pix.png) as an extra safety feature.
- No, it is not possible to receive DMX and then convert it to pixels. You can only use it to output pixel data. Can I suggest you look at the WLED project for that? Linked [here](https://github.com/Aircoookie/WLED).

I have unofficially taken over this project, as Matt seems to be offline / not contributing to this project anymore. We sell a version of this project on our website: [expanseelectronics.com](https://expanseelectronics.com), and you are free to send us an email at any time with any further questions.

lesleylemmens, 2023-04-23:
Thank you for your response!

finnie2006, 2023-09-11:
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

You have every right to do this, but why are you offering an open source project for sale on your own hardware for a pretty high amount of money

casesolved-co-uk, 2024-01-18:
https://github.com/mtongnz/ESP8266_ArtNetNode_v2/issues/148

Thread 148 (2024-01-18):

Forget this project and use WLED!

casesolved-co-uk, 2024-01-18:
Having spent a long time updating this project and finding that it has a heap of bugs and instabilities, is difficult to develop, etc, I then stumbled upon [WLED](https://github.com/Aircoookie/WLED/).

It is far more advanced, feature rich and stable, though the DMX features aren't quite as good (no RDM).

Trust me, you won't look back!

M Tong still deserves a lot of credit for his work though. I suspect this project inspired WLED and a lot of code has been borrowed and changed beyond recognition.

Thanks!

wy1d, 2025-05-17:
> WLED is far more advanced, feature rich and stable, though the DMX features aren't quite as good (no RDM).

Cool! I'm looking through it now but not seeing support for wiring the DMX plug itself to the ESP32/8266. I actually have a bunch of ESP32 lying around I was hoping to use for an artnet adapter but also fine with picking up an ESP8266 if that's all that is supported by the project. Just having a hard time getting a parts list together for a lot that I can print a box for and use with my DMX hex pars!

casesolved-co-uk, 2025-05-17:
Yes WLED supports ESP32
You just have to convert the serial to differential serial, plenty of chips out there. ESP32 has lots of UARTs and you can assign them to any pin but check with WLED the ones it supports. The DMX functionality is pretty sketchy.
Or there's this:
https://www.racitup.com/products/supernode1

wy1d, 2025-05-17:
> The DMX functionality is pretty sketchy. Or there's this: https://www.racitup.com/products/supernode1

Hey awesome!! Thanks for the reply and link! That's exactly what I've been searching for and / or trying to build. I'm a decent enough at tinkering to build from a kit of list of components but that Supernode looks like a great option. I'm in the US though so not sure if I'll be able to get my hands on one here.

Looks like it runs WLED though so will the DMX be sketchy on it?

casesolved-co-uk, 2025-05-18:
It's actually one of my side projects. I rewrote the DMX side of things because I use it for a theatre group, but you might find the standard WLED driver does what you need. I just didn't like the look of the code because it blocks all the time it is outputting and I don't think it supports DMX input. It has been a while since I looked.

If you're feeling really brave you can try and integrate my driver into WLED, it was pretty tricky and I only tried it on the ESP8266:

https://github.com/casesolved-co-uk/DMXUART

If you use that chip the software from the racitup.com should work on it and they are dirt cheap.

If not you can contact me through the website and I'll look into postage to the US if you're keen. Last time I purchased from the US the postage was pretty pricey. I've not tried exporting before.

wy1d, 2025-05-18:
> If not you can contact me through the website and I'll look into postage to the US if you're keen. Last time I purchased from the US the postage was pretty pricey. I've not tried exporting before.

Message sent!
