mtongnz/ESP8266_ArtNetNode_v2/source/espArtnetNode_2.0.0_b5g.ino

/*
ESP8266_ArtNetNode v2.0.0
Copyright (c) 2016, Matthew Tong
https://github.com/mtongnz/ESP8266_ArtNetNode_v2

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
Note:
This is a pre-release version of this software.  It is not yet ready for prime time and contains bugs (known and unknown).
Please submit any bugs or code changes so they can be included into the next release.

Prizes up for grabs:
I am giving away a few of my first batch of prototype PCBs.  They will be fully populated - valued at over $30 just for parts.
In order to recieve one, please complete one of the following tasks.  You can "win" multiple boards.
1 - Fix the WDT reset issue (https://github.com/mtongnz/ESP8266_ArtNetNode_v2/issues/41)
2 - Implement stored scenes function.  I want it to allow for static scenes or for chases to run.
3 - Most bug fixes, code improvements, feature additions & helpful submissions.
    eg. Fixing the flickering WS2812 (https://github.com/mtongnz/ESP8266_ArtNetNode_v2/issues/36)
        Adding other pixel strips (https://github.com/mtongnz/ESP8266_ArtNetNode_v2/issues/42)
        Creating new web UI theme (https://github.com/mtongnz/ESP8266_ArtNetNode_v2/issues/22)
        
These prizes will be based on the first person to submit a solution that I judge to be adequate.  My decision is final.
This competition will open to the general public a couple of weeks after the private code release to supporters.
*/

#include <ESP8266WiFi.h>
#include <WiFiClient.h>
#include <ESP8266WebServer.h>
#include <ArduinoJson.h>
#include <EEPROM.h>
#include <FS.h>
#include "store.h"
#include "espDMX_RDM.h"
#include "espArtNetRDM.h"
#include "ws2812Driver.h"
#include "wsFX.h"

extern "C" {
  #include "user_interface.h"
  extern struct rst_info resetInfo;
}

#define FIRMWARE_VERSION "v2.0.0 (beta 5g)"
#define ART_FIRM_VERSION 0x0200   // Firmware given over Artnet (2 bytes)


//#define ESP_01              // Un comment for ESP_01 board settings
//#define NO_RESET            // Un comment to disable the reset button

// Wemos boards use 4M (3M SPIFFS) compiler option


#define ARTNET_OEM 0x0123    // Artnet OEM Code
#define ESTA_MAN 0x08DD      // ESTA Manufacturer Code
#define ESTA_DEV 0xEE000000  // RDM Device ID (used with Man Code to make 48bit UID)






#ifdef ESP_01
  #define DMX_DIR_A 2   // Same pin as TX1
  #define DMX_TX_A 1
  #define ONE_PORT
  #define NO_RESET

  #define WS2812_ALLOW_INT_SINGLE false
  #define WS2812_ALLOW_INT_DOUBLE false
  
#else
  #define DMX_DIR_A 5   // D1
  #define DMX_DIR_B 16  // D0
  #define DMX_TX_A 1
  #define DMX_TX_B 2

  #define STATUS_LED_PIN 12
//  #define STATUS_LED_MODE_WS2812
  #define STATUS_LED_MODE_APA106
  #define STATUS_LED_A 0  // Physical wiring order for status LEDs
  #define STATUS_LED_B 1
  #define STATUS_LED_S 2
  
  #define WS2812_ALLOW_INT_SINGLE false
  #define WS2812_ALLOW_INT_DOUBLE false
#endif

#ifndef NO_RESET
  #define SETTINGS_RESET 14
#endif


// Definitions for status leds  xxBBRRGG
#define BLACK 0x00000000
#define WHITE 0x00FFFFFF
#define RED 0x0000FF00
#define GREEN 0x000000FF
#define BLUE 0x00FF0000
#define CYAN 0x00FF00FF
#define PINK 0x0066FF22
#define MAGENTA 0x00FFFF00
#define YELLOW 0x0000FFFF
#define ORANGE 0x0000FF33
#define STATUS_DIM 0x0F

uint8_t portA[5], portB[5];
uint8_t MAC_array[6];
uint8_t dmxInSeqID = 0;
uint8_t statusLedData[9] = {0, 0, 0, 0, 0, 0, 0, 0, 0};
uint32_t statusTimer = 0;

esp8266ArtNetRDM artRDM;
ESP8266WebServer webServer(80);
DynamicJsonBuffer jsonBuffer;
ws2812Driver pixDriver;
File fsUploadFile;
bool statusLedsDim = true;
bool statusLedsOff = false;

pixPatterns pixFXA(0, &pixDriver);
pixPatterns pixFXB(1, &pixDriver);

const char PROGMEM mainPage[] = "<!DOCTYPE html><meta content='text/html; charset=utf-8' http-equiv=Content-Type /><title>ESP8266 ArtNetNode Config</title><meta content='Matthew Tong - http://github.com/mtongnz/' name=DC.creator /><meta content=en name=DC.language /><meta content='width=device-width,initial-scale=1' name=viewport /><link href=style.css rel=stylesheet /><div id=page><div class=inner><div class=mast><div class=title>esp8266<h1>ArtNet & sACN</h1>to<h1>DMX & LED Pixels</h1></div><ul class=nav><li class=first><a href='javascript: menuClick(1)'>Device Status</a><li><a href='javascript: menuClick(2)'>WiFi</a><li><a href='javascript: menuClick(3)'>IP & Name</a><li><a href='javascript: menuClick(4)'>Port A</a>"
    #ifndef ONE_PORT
      "<li><a href='javascript: menuClick(5)'>Port B</a>"
    #endif
  "<li><a href='javascript: menuClick(6)'>Scenes</a><li><a href='javascript: menuClick(7)'>Firmware</a><li class=last><a href='javascript: reboot()'>Reboot</a></ul><div class=author><i>Design by</i> Matthew Tong</div></div><div class='main section'><div class=hide name=error><h2>Error</h2><p class=center>There was an error communicating with the device. Refresh the page and try again.</div><div class=show name=sections><h2>Fetching Data</h2><p class=center>Fetching data from device. If this message is still here in 15 seconds, try refreshing the page or clicking the menu option again.</div><div class=hide name=sections><h2>Device Status</h2><p class=left>Device Name:<p class=right name=nodeName><p class=left>MAC Address:<p class=right name=macAddress><p class=left>Wifi Status:<p class=right name=wifiStatus><p class=left>IP Address:<p class=right name=ipAddressT><p class=left>Subnet Address:<p class=right name=subAddressT><p class=left>Port A:<p class=right name=portAStatus>"
    #ifndef ONE_PORT
      "<p class=left>Port B:<p class=right name=portBStatus>"
    #endif
  "<p class=left>Scene Storage:<p class=right name=sceneStatus><p class=left>Firmware:<p class=right name=firmwareStatus></div><div class=hide name=sections><input name=save type=button value='Save Changes'/><h2>WiFi Settings</h2><p class=left>MAC Address:<p class=right name=macAddress><p class=spacer><p class=left>Wifi SSID:<p class=right><input type=text name=wifiSSID /><p class=left>Password:<p class=right><input type=text name=wifiPass /><p class=spacer><p class=left>Hotspot SSID:<p class=right><input type='text' name='hotspotSSID' /><p class=left>Password:<p class=right><input type=text name=hotspotPass /><p class=left>Start Delay:<p class=right><input name=hotspotDelay type=number min=0 max=180 class=number /> (seconds)<p class=spacer><p class=left>Stand Alone:<p class=right><input name=standAloneEnable type=checkbox value=true /><p class=right>In normal mode, the hotspot will start after <i>delay</i> seconds if the main WiFi won't connect. If no users connect, the device will reset and attempt the main WiFi again. This feature is purely for changing settings and ArtNet data is ignored.<p class=right>Stand alone mode disables the primary WiFi connection and allows ArtNet data to be received via the hotspot connection.</div><div class=hide name=sections><input name=save type=button value='Save Changes'/><h2>IP & Node Name</h2><p class='left'>Short Name:</p><p class=right><input type=text name=nodeName /><p class=left>Long Name:<p class=right><input type=text name=longName /><p class=spacer><p class=left>Enable DHCP:<p class=right><input name=dhcpEnable type=checkbox value=true /><p class=left>IP Address:<p class=right><input name=ipAddress type=number min=0 max=255 class=number /> <input name=ipAddress type=number min=0 max=255 class=number /> <input name=ipAddress type=number min=0 max=255 class=number /> <input name=ipAddress type=number min=0 max=255 class=number /><p class=left>Subnet Address:<p class=right><input name=subAddress type=number min=0 max=255 class=number /> <input name=subAddress type=number min=0 max=255 class=number /> <input name=subAddress type=number min=0 max=255 class=number /> <input name=subAddress type=number min=0 max=255 class=number /><p class=left>Gateway Address:<p class=right><input name=gwAddress type=number min=0 max=255 class=number /> <input name=gwAddress type=number min=0 max=255 class=number /> <input name=gwAddress type=number min=0 max=255 class=number /> <input name=gwAddress type=number min=0 max=255 class=number /><p class=left>Broadcast Address:<p class=right name=bcAddress><p class=center>These settings only affect the main WiFi connection. The hotspot will always have DHCP enabled and an IP of <b>2.0.0.1</b></div><div class=hide name=sections><input name=save type=button value='Save Changes'/><h2>Port A Settings</h2><p class=left>Port Type:<p class=right><select class=select name=portAmode><option value=0>DMX Output<option value=1>DMX Output with RDM<option value=2>DMX Input<option value=3>LED Pixels - WS2812</select><p class=left>Protocol:<p class=right><select class=select name=portAprot><option value=0>Artnet v4<option value=1>Artnet v4 with sACN DMX</select><p class=left>Merge Mode:<p class=right><select class=select name=portAmerge><option value=0>Merge LTP<option value=1>Merge HTP</select><p class=left>Net:<p class=right><input name=portAnet type=number min=0 max=127 class=number /><p class=left>Subnet:<p class=right><input name=portAsub type=number min=0 max=15 class=number /><p class=left>Universe:<p class=right><input type=number min=0 max=15 name=portAuni class=number /><span name=portApix> <input type=number min=0 max=15 name=portAuni class=number /> <input type=number min=0 max=15 name=portAuni class=number /> <input type=number min=0 max=15 name=portAuni class=number /></span></p><p class=left>sACN Universe:<p class=right><input type=number min=0 max=63999 name=portAsACNuni class=number /> <input type=number min=1 max=63999 name=portAsACNuni class=number /> <input type=number min=1 max=63999 name=portAsACNuni class=number /> <input type=number min=1 max=63999 name=portAsACNuni class=number /></p><span name=DmxInBcAddrA><p class=left>Broadcast Address:<p class=right><input type=number min=0 max=255 name=dmxInBroadcast class=number /> <input type=number min=0 max=255 name=dmxInBroadcast class=number /> <input type=number min=0 max=255 name=dmxInBroadcast class=number /> <input type=number min=0 max=255 name=dmxInBroadcast class=number /></p></span><span name=portApix><p class=left>Number of Pixels:<p class=right><input type=number min=0 max=680 name=portAnumPix class=number /> 680 max - 170 per universe</p><p class=left>Mode:</p><p class=right><select class=select name=portApixMode><option value=0>Pixel Mapping</option><option value=1>12 Channel FX</option></select><p class=left>Start Channel:</p><p class=right><input type=number name=portApixFXstart class=number min=1 max=501 /> FX modes only</p></span></div><div class=hide name=sections><input name=save type=button value='Save Changes'/><h2>Port B Settings</h2><p class=left>Port Type:<p class=right><select class=select name=portBmode><option value=0>DMX Output<option value=1>DMX Output with RDM<option value=3>LED Pixels - WS2812</select><p class=left>Protocol:<p class=right><select class=select name=portBprot><option value=0>Artnet v4<option value=1>Artnet v4 with sACN DMX</select><p class=left>Merge Mode:<p class=right><select class=select name=portBmerge><option value=0>Merge LTP<option value=1>Merge HTP</select><p class=left>Net:<p class=right><input name=portBnet type=number min=0 max=127 class=number /><p class=left>Subnet:<p class=right><input name=portBsub type=number min=0 max=15 class=number /><p class=left>Universe:<p class=right><input type=number min=0 max=15 name=portBuni class=number /><span name=portBpix> <input type=number min=0 max=15 name=portBuni class=number /> <input type=number min=0 max=15 name=portBuni class=number /> <input type=number min=0 max=15 name=portBuni class=number /></span></p><p class=left>sACN Universe:<p class=right><input type=number min=1 max=63999 name=portBsACNuni class=number /> <input type=number min=1 max=63999 name=portBsACNuni class=number /> <input type=number min=1 max=63999 name=portBsACNuni class=number /> <input type=number min=1 max=63999 name=portBsACNuni class=number /></p><span name=portBpix><p class=left>Number of Pixels:<p class=right><input type=number min=0 max=680 name=portBnumPix class=number /> 680 max - 170 per universe</p><p class=left>Mode:</p><p class=right><select class=select name=portBpixMode><option value=0>Pixel Mapping</option><option value=1>12 Channel FX</option></select><p class=left>Start Channel:</p><p class=right><input type=number name=portBpixFXstart class=number min=1 max=501 /> FX modes only</p></span></div><div class=hide name=sections><h2>Stored Scenes</h2><p class=center>Not yet implemented</div><div class=hide name=sections><form action=/update enctype=multipart/form-data method=POST id=firmForm><h2>Update Firmware</h2><p class=left>Firmware:<p class=right name=firmwareStatus><p class=right><input name=update type=file id=update><label for=update><svg height=17 viewBox='0 0 20 17' width=20 xmlns=http://www.w3.org/2000/svg><path d='M10 0l-5.2 4.9h3.3v5.1h3.8v-5.1h3.3l-5.2-4.9zm9.3 11.5l-3.2-2.1h-2l3.4 2.6h-3.5c-.1 0-.2.1-.2.1l-.8 2.3h-6l-.8-2.2c-.1-.1-.1-.2-.2-.2h-3.6l3.4-2.6h-2l-3.2 2.1c-.4.3-.7 1-.6 1.5l.6 3.1c.1.5.7.9 1.2.9h16.3c.6 0 1.1-.4 1.3-.9l.6-3.1c.1-.5-.2-1.2-.7-1.5z'/></svg> <span>Choose Firmware</span></label><p class=right id=uploadMsg></p><p class=right><input type=button class=submit value='Upload Now' id=fUp></div></div><div class=footer><p>Coding and hardware © 2016-2017 <a href=http://github.com/mtongnz/ >Matthew Tong</a>.<p>Released under <a href=http://www.gnu.org/licenses/ >GNU General Public License V3</a>.</div></div></div><script>var cl=0;var num=0;var err=0;var o=document.getElementsByName('sections');var s=document.getElementsByName('save');for (var i=0, e; e=s[i++];)e.addEventListener( 'click', function(){sendData();}); var u=document.getElementById('fUp');var um=document.getElementById('uploadMsg');var fileSelect=document.getElementById('update');u.addEventListener('click',function(){uploadPrep()});function uploadPrep(){if(fileSelect.files.length===0) return;u.disabled=!0;u.value='Preparing Device…';var x=new XMLHttpRequest();x.onreadystatechange=function(){if(x.readyState==XMLHttpRequest.DONE){try{var r=JSON.parse(x.response)}catch(e){var r={success:0,doUpdate:1}} if(r.success==1&&r.doUpdate==1){uploadWait()}else{um.value='<b>Update failed!</b>';u.value='Upload Now';u.disabled=!1}}};x.open('POST','/ajax',!0);x.setRequestHeader('Content-Type','application/json');x.send('{\"doUpdate\":1,\"success\":1}')} function uploadWait(){setTimeout(function(){var z=new XMLHttpRequest();z.onreadystatechange=function(){if(z.readyState==XMLHttpRequest.DONE){try{var r=JSON.parse(z.response)}catch(e){var r={success:0}} console.log('r=' + r.success); if(r.success==1){upload()}else{uploadWait()}}};z.open('POST','/ajax',!0);z.setRequestHeader('Content-Type','application/json');z.send('{\"doUpdate\":2,\"success\":1}')},1000)} var upload=function(){u.value='Uploading… 0%';var data=new FormData();data.append('update',fileSelect.files[0]);var x=new XMLHttpRequest();x.onreadystatechange=function(){if(x.readyState==4){try{var r=JSON.parse(x.response)}catch(e){var r={success:0,message:'No response from device.'}} console.log(r.success+': '+r.message);if(r.success==1){u.value=r.message;setTimeout(function(){location.reload()},15000)}else{um.value='<b>Update failed!</b> '+r.message;u.value='Upload Now';u.disabled=!1}}};x.upload.addEventListener('progress',function(e){var p=Math.ceil((e.loaded/e.total)*100);console.log('Progress: '+p+'%');if(p<100) u.value='Uploading... '+p+'%';else u.value='Upload complete. Processing…'},!1);x.open('POST','/upload',!0);x.send(data)}; function reboot() { if (err == 1) return; var r = confirm('Are you sure you want to reboot?'); if (r != true) return; o[cl].className = 'hide'; o[0].childNodes[0].innerHTML = 'Rebooting'; o[0].childNodes[1].innerHTML = 'Please wait while the device reboots. This page will refresh shortly unless you changed the IP or Wifi.'; o[0].className = 'show'; err = 0; var x = new XMLHttpRequest(); x.onreadystatechange = function(){ if(x.readyState == 4){ try { var r = JSON.parse(x.response); } catch (e){ var r = {success: 0, message: 'Unknown error: [' + x.responseText + ']'}; } if (r.success != 1) { o[0].childNodes[0].innerHTML = 'Reboot Failed'; o[0].childNodes[1].innerHTML = 'Something went wrong and the device didn\\'t respond correctly. Please try again.'; } setTimeout(function() { location.reload(); }, 5000); } }; x.open('POST', '/ajax', true); x.setRequestHeader('Content-Type', 'application/json'); x.send('{\"reboot\":1,\"success\":1}'); } function sendData(){var d={'page':num};for (var i=0, e; e=o[cl].getElementsByTagName('INPUT')[i++];){var k=e.getAttribute('name');var v=e.value;if (k in d) continue; if (k=='ipAddress' || k=='subAddress' || k=='gwAddress' || k=='portAuni' || k=='portBuni' || k=='portAsACNuni' || k=='portBsACNuni' || k=='dmxInBroadcast'){var c=[v];for (var z=1; z < 4; z++){c.push(o[cl].getElementsByTagName('INPUT')[i++].value);}d[k]=c; continue;}if (e.type==='text')d[k]=v;if (e.type==='number'){if (v=='')v=0;d[k]=v;}if (e.type==='checkbox'){if (e.checked)d[k]=1;else d[k]=0;}}for (var i=0, e; e=o[cl].getElementsByTagName('SELECT')[i++];){d[e.getAttribute('name')]=e.options[e.selectedIndex].value;}d['success']=1;var x=new XMLHttpRequest();x.onreadystatechange=function(){handleAJAX(x);};x.open('POST', '/ajax');x.setRequestHeader('Content-Type', 'application/json');x.send(JSON.stringify(d));console.log(d);} function menuClick(n){if (err==1) return; num=n; setTimeout(function(){if (cl==num || err==1) return; o[cl].className='hide'; o[0].className='show'; cl=0;}, 100); var x=new XMLHttpRequest(); x.onreadystatechange=function(){handleAJAX(x);}; x.open('POST', '/ajax'); x.setRequestHeader('Content-Type', 'application/json'); x.send(JSON.stringify({\"page\":num,\"success\":1}));}function handleAJAX(x){if (x.readyState==XMLHttpRequest.DONE ){if (x.status==200){var response=JSON.parse(x.responseText);console.log(response);if (!response.hasOwnProperty('success')){err=1; o[cl].className='hide'; document.getElementsByName('error')[0].className='show';return;}if (response['success'] !=1){err=1; o[cl].className='hide';document.getElementsByName('error')[0].getElementsByTagName('P')[0].innerHTML=response['message']; document.getElementsByName('error')[0].className='show';return;}if (response.hasOwnProperty('message')) { for (var i = 0, e; e = s[i++];) { e.value = response['message']; e.className = 'showMessage' } setTimeout(function() { for (var i = 0, e; e = s[i++];) { e.value = 'Save Changes'; e.className = '' } }, 5000); } o[cl].className='hide'; o[num].className='show'; cl=num; for (var key in response){if (response.hasOwnProperty(key)){var a=document.getElementsByName(key); if (key=='ipAddress' || key=='subAddress'){var b=document.getElementsByName(key + 'T'); for (var z=0; z < 4; z++){a[z].value=response[key][z]; if (z==0) b[0].innerHTML=''; else b[0].innerHTML=b[0].innerHTML + ' . '; b[0].innerHTML=b[0].innerHTML + response[key][z];}continue;}else if (key=='bcAddress'){for (var z=0; z < 4; z++){if (z==0) a[0].innerHTML=''; else a[0].innerHTML=a[0].innerHTML + ' . '; a[0].innerHTML=a[0].innerHTML + response[key][z];}continue;} else if (key=='gwAddress' || key=='dmxInBroadcast' || key=='portAuni' || key=='portBuni' || key=='portAsACNuni' || key=='portBsACNuni'){for(var z=0;z<4;z++){a[z].value = response[key][z];}continue}if(key=='portAmode'){var b = document.getElementsByName('portApix');var c = document.getElementsByName('DmxInBcAddrA');if(response[key] == 3) {b[0].style.display = '';b[1].style.display = '';} else {b[0].style.display = 'none';b[1].style.display = 'none';}if (response[key] == 2){c[0].style.display = '';}else{c[0].style.display = 'none';}} else if (key == 'portBmode') {var b = document.getElementsByName('portBpix');if(response[key] == 3) {b[0].style.display = '';b[1].style.display = '';} else {b[0].style.display = 'none';b[1].style.display = 'none';}}for (var z=0; z < a.length; z++){switch (a[z].nodeName){case 'P': case 'DIV': a[z].innerHTML=response[key]; break; case 'INPUT': if (a[z].type=='checkbox'){if (response[key]==1) a[z].checked=true; else a[z].checked=false;}else a[z].value=response[key]; break; case 'SELECT': for (var y=0; y < a[z].options.length; y++){if (a[z].options[y].value==response[key]){a[z].options.selectedIndex=y; break;}}break;}}}}}else{err=1; o[cl].className='hide'; document.getElementsByName('error')[0].className='show';}}}var update=document.getElementById('update');var label=update.nextElementSibling;var labelVal=label.innerHTML;update.addEventListener( 'change', function( e ){var fileName=e.target.value.split( '\\\\' ).pop(); if( fileName ) label.querySelector( 'span' ).innerHTML=fileName; else label.innerHTML=labelVal; update.blur();}); document.onkeydown=function(e){if(cl < 2 || cl > 6)return; var e = e||window.event; if (e.keyCode == 13)sendData();}; menuClick(1);</script></body></html>";

const char PROGMEM cssUploadPage[] = "<html><head><title>espArtNetNode CSS Upload</title></head><body>Select and upload your CSS file.  This will overwrite any previous uploads but you can restore the default below.<br /><br /><form method='POST' action='/style_upload' enctype='multipart/form-data'><input type='file' name='css'><input type='submit' value='Upload New CSS'></form><br /><a href='/style_delete'>Restore default CSS</a></body></html>";

const char PROGMEM css[] = ".author,.title,ul.nav a{text-align:center}.author i,.show,.title h1,ul.nav a{display:block}input,ul.nav a:hover{background-color:#DADADA}a,abbr,acronym,address,applet,b,big,blockquote,body,caption,center,cite,code,dd,del,dfn,div,dl,dt,em,fieldset,font,form,h1,h2,h3,h4,h5,h6,html,i,iframe,img,ins,kbd,label,legend,li,object,ol,p,pre,q,s,samp,small,span,strike,strong,sub,sup,table,tbody,td,tfoot,th,thead,tr,tt,u,ul,var{margin:0;padding:0;border:0;outline:0;font-size:100%;vertical-align:baseline;background:0 0}.main h2,li.last{border-bottom:1px solid #888583}body{line-height:1;background:#E4E4E4;color:#292929;color:rgba(0,0,0,.82);font:400 100% Cambria,Georgia,serif;-moz-text-shadow:0 1px 0 rgba(255,255,255,.8);}ol,ul{list-style:none}a{color:#890101;text-decoration:none;-moz-transition:.2s color linear;-webkit-transition:.2s color linear;transition:.2s color linear}a:hover{color:#DF3030}#page{padding:0}.inner{margin:0 auto;width:91%}.amp{font-family:Baskerville,Garamond,Palatino,'Palatino Linotype','Hoefler Text','Times New Roman',serif;font-style:italic;font-weight:400}.mast{float:left;width:31.875%}.title{font:semi 700 16px/1.2 Baskerville,Garamond,Palatino,'Palatino Linotype','Hoefler Text','Times New Roman',serif;padding-top:0}.title h1{font:700 20px/1.2 'Book Antiqua','Palatino Linotype',Georgia,serif;padding-top:0}.author{font:400 100% Cambria,Georgia,serif}.author i{font:400 12px Baskerville,Garamond,Palatino,'Palatino Linotype','Hoefler Text','Times New Roman',serif;letter-spacing:.05em;padding-top:.7em}.footer,.main{float:right;width:65.9375%}ul.nav{margin:1em auto 0;width:11em}ul.nav a{font:700 14px/1.2 'Book Antiqua','Palatino Linotype',Georgia,serif;letter-spacing:.1em;padding:.7em .5em;margin-bottom:0;text-transform:uppercase}input[type=button],input[type=button]:focus{background-color:#E4E4E4;color:#890101}li{border-top:1px solid #888583}.hide{display:none}.main h2{font-size:1.4em;text-align:left;margin:0 0 1em;padding:0 0 .3em}.main{position:relative}p.left{clear:left;float:left;width:20%;min-width:120px;max-width:300px;margin:0 0 .6em;padding:0;text-align:right}p.right,select{min-width:200px}p.right{overflow:auto;margin:0 0 .6em .4em;padding-left:.6em;text-align:left}p.center,p.spacer{padding:0;display:block}.footer,p.center{text-align:center}p.center{float:left;clear:both;margin:3em 0 3em 15%;width:70%}p.spacer{float:left;clear:both;margin:0;width:100%;height:20px}input{margin:0;border:0;color:#890101;outline:0;font:400 100% Cambria,Georgia,serif}input[type=text]{width:70%;min-width:200px;padding:0 5px}input[type=number]{min-width:50px;width:50px}input:focus{background-color:silver;color:#000}input[type=checkbox]{-webkit-appearance:none;background-color:#fafafa;border:1px solid #cacece;box-shadow:0 1px 2px rgba(0,0,0,.05),inset 0 -15px 10px -12px rgba(0,0,0,.05);padding:9px;border-radius:5px;display:inline-block;position:relative}input[type=checkbox]:active,input[type=checkbox]:checked:active{box-shadow:0 1px 2px rgba(0,0,0,.05),inset 0 1px 3px rgba(0,0,0,.1)}input[type=checkbox]:checked{background-color:#fafafa;border:1px solid #adb8c0;box-shadow:0 1px 2px rgba(0,0,0,.05),inset 0 -15px 10px -12px rgba(0,0,0,.05),inset 15px 10px -12px rgba(255,255,255,.1);color:#99a1a7}input[type=checkbox]:checked:after{content:'\\2714';font-size:14px;position:absolute;top:0;left:3px;color:#890101}input[type=button],input[type=file]+label{font:700 16px/1.2 'Book Antiqua','Palatino Linotype',Georgia,serif;margin:17px 0 0}input[type=button]{position:absolute;right:0;display:block;border:1px solid #adb8c0;float:right;border-radius:12px;padding:5px 20px 2px 23px;-webkit-transition-duration:.3s;transition-duration:.3s}input[type=button]:hover{background-color:#909090;color:#fff;padding:5px 62px 2px 65px}input.submit{float:left;position: relative}input.showMessage,input.showMessage:focus,input.showMessage:hover{background-color:#6F0;color:#000;padding:5px 62px 2px 65px}input[type=file]{width:.1px;height:.1px;opacity:0;overflow:hidden;position:absolute;z-index:-1}input[type=file]+label{float:left;clear:both;cursor:pointer;border:1px solid #adb8c0;border-radius:12px;padding:5px 20px 2px 23px;display:inline-block;background-color:#E4E4E4;color:#890101;overflow:hidden;-webkit-transition-duration:.3s;transition-duration:.3s}input[type=file]+label:hover,input[type=file]:focus+label{background-color:#909090;color:#fff;padding:5px 40px 2px 43px}input[type=file]+label svg{width:1em;height:1em;vertical-align:middle;fill:currentColor;margin-top:-.25em;margin-right:.25em}select{margin:0;border:0;background-color:#DADADA;color:#890101;outline:0;font:400 100% Cambria,Georgia,serif;width:50%;padding:0 5px}.footer{border-top:1px solid #888583;display:block;font-size:12px;margin-top:20px;padding:.7em 0 20px}.footer p{margin-bottom:.5em}@media (min-width:600px){.inner{min-width:600px}}@media (max-width:600px){.inner,.page{min-width:300px;width:100%;overflow-x:hidden}.footer,.main,.mast{float:left;width:100%}.mast{border-top:1px solid #888583;border-bottom:1px solid #888583}.main{margin-top:4px;width:98%}ul.nav{margin:0 auto;width:100%}ul.nav li{float:left;min-width:100px;width:33%}ul.nav a{font:12px Helvetica,Arial,sans-serif;letter-spacing:0;padding:.8em}.title,.title h1{padding:0;text-align:center}ul.nav a:focus,ul.nav a:hover{background-position:0 100%}.author{display:none}.title{border-bottom:1px solid #888583;width:100%;display:block;font:400 15px Baskerville,Garamond,Palatino,'Palatino Linotype','Hoefler Text','Times New Roman',serif}.title h1{font:600 15px Baskerville,Garamond,Palatino,'Palatino Linotype','Hoefler Text','Times New Roman',serif;display:inline}p.left,p.right{clear:both;float:left;margin-right:1em}li,li.first,li.last{border:0}p.left{width:100%;text-align:left;margin-left:.4em;font-weight:600}p.right{margin-left:1em;width:100%}p.center{margin:1em 0;width:100%}p.spacer{display:none}input[type=text],select{width:85%;}@media (min-width:1300px){.page{width:1300px}}";
const char PROGMEM typeHTML[] = "text/html";
const char PROGMEM typeCSS[] = "text/css";

char wifiStatus[60] = "";
bool isHotspot = false;
uint32_t nextNodeReport = 0;
char nodeError[ARTNET_NODE_REPORT_LENGTH] = "";
bool nodeErrorShowing = 1;
uint32_t nodeErrorTimeout = 0;
bool pixDone = true;
bool newDmxIn = false;
bool doReboot = false;
byte* dataIn;

void setup(void) {
  //pinMode(4, OUTPUT);
  //digitalWrite(4, LOW);

  // Make direction input to avoid boot garbage being sent out
  pinMode(DMX_DIR_A, OUTPUT);
  digitalWrite(DMX_DIR_A, LOW);
  #ifndef ONE_PORT
    pinMode(DMX_DIR_B, OUTPUT);
    digitalWrite(DMX_DIR_B, LOW);
  #endif

  #ifndef ESP_01
    pinMode(STATUS_LED_PIN, OUTPUT);
    digitalWrite(STATUS_LED_PIN, LOW);
    delay(1);
    setStatusLed(STATUS_LED_S, PINK);
    doStatusLedOutput();
  #endif

  wifi_set_sleep_type(NONE_SLEEP_T);
  bool resetDefaults = false;
  
  #ifdef SETTINGS_RESET
    pinMode(SETTINGS_RESET, INPUT);

    delay(5);
    // button pressed = low reading
    if (!digitalRead(SETTINGS_RESET)) {
      delay(50);
      if (!digitalRead(SETTINGS_RESET))
        resetDefaults = true;
    }
  #endif
  
  // Start EEPROM
  EEPROM.begin(512);

  // Start SPIFFS file system
  SPIFFS.begin();

  // Check if SPIFFS formatted
  if (SPIFFS.exists("/formatted.txt")) {
    SPIFFS.format();
    
    File f = SPIFFS.open("/formatted.txt", "w");
    f.print("Formatted");
    f.close();
  }

  // Load our saved values or store defaults
  if (!resetDefaults)
    eepromLoad();

  // Store our counters for resetting defaults
  if (resetInfo.reason != REASON_DEFAULT_RST && resetInfo.reason != REASON_EXT_SYS_RST && resetInfo.reason != REASON_SOFT_RESTART)
    deviceSettings.wdtCounter++;
  else
    deviceSettings.resetCounter++;

  // Store values
  eepromSave();

  // Start wifi
  wifiStart();

  // Start web server
  webStart();

  
  // Don't start our Artnet or DMX in firmware update mode or after multiple WDT resets
  if (!deviceSettings.doFirmwareUpdate && deviceSettings.wdtCounter <= 3) {

    // We only allow 1 DMX input - and RDM can't run alongside DMX in
    if (deviceSettings.portAmode == TYPE_DMX_IN && deviceSettings.portBmode == TYPE_RDM_OUT)
      deviceSettings.portBmode = TYPE_DMX_OUT;
    
    // Setup Artnet Ports & Callbacks
    artStart();

    // Don't open any ports for a bit to let the ESP spill it's garbage to serial
    while (millis() < 3500)
      yield();
    
    // Port Setup
    portSetup();

  } else
    deviceSettings.doFirmwareUpdate = false;

  delay(10);
}

void loop(void){
  // If the device lasts for 6 seconds, clear our reset timers
  if (deviceSettings.resetCounter != 0 && millis() > 6000) {
    deviceSettings.resetCounter = 0;
    deviceSettings.wdtCounter = 0;
    eepromSave();
  }
  
  webServer.handleClient();
  
  // Get the node details and handle Artnet
  doNodeReport();
  artRDM.handler();
  
  yield();

  // DMX handlers
  dmxA.handler();
  #ifndef ONE_PORT
    dmxB.handler();
  #endif

  // Do Pixel FX on port A
  if (deviceSettings.portAmode == TYPE_WS2812 && deviceSettings.portApixMode != FX_MODE_PIXEL_MAP) {
    if (pixFXA.Update())
      pixDone = 0;
  }

  // Do Pixel FX on port B
  #ifndef ONE_PORT
    if (deviceSettings.portBmode == TYPE_WS2812 && deviceSettings.portBpixMode != FX_MODE_PIXEL_MAP) {
      if (pixFXB.Update())
        pixDone = 0;
    }
  #endif

  // Do pixel string output
  if (!pixDone)
    pixDone = pixDriver.show();
  
  // Handle received DMX
  if (newDmxIn) { 
    uint8_t g, p, n;
    
    newDmxIn = false;

    g = portA[0];
    p = portA[1];
    
    IPAddress bc = deviceSettings.dmxInBroadcast;
    artRDM.sendDMX(g, p, bc, dataIn, 512);

    #ifndef ESP_01
      setStatusLed(STATUS_LED_A, CYAN);
    #endif
  }

  // Handle rebooting the system
  if (doReboot) {
    char c[ARTNET_NODE_REPORT_LENGTH] = "Device rebooting...";
    artRDM.setNodeReport(c, ARTNET_RC_POWER_OK);
    artRDM.artPollReply();
    
    // Ensure all web data is sent before we reboot
    uint32_t n = millis() + 1000;
    while (millis() < n)
      webServer.handleClient();

    ESP.restart();
  }
  
  #ifdef STATUS_LED_PIN
    // Output status to LEDs once per second
    if (statusTimer < millis()) {

      // Flash our main status LED
      if ((statusTimer % 2000) > 1000)
        setStatusLed(STATUS_LED_S, BLACK);
      else if (nodeError[0] != '\0')
        setStatusLed(STATUS_LED_S, RED);
      else
        setStatusLed(STATUS_LED_S, GREEN);

      doStatusLedOutput();
      statusTimer = millis() + 1000;
    }
  #endif
}

void dmxHandle(uint8_t group, uint8_t port, uint16_t numChans, bool syncEnabled) {
  if (portA[0] == group) {
    if (deviceSettings.portAmode == TYPE_WS2812) {
      
      #ifndef ESP_01
        setStatusLed(STATUS_LED_A, GREEN);
      #endif
      
      if (deviceSettings.portApixMode == FX_MODE_PIXEL_MAP) {
        if (numChans > 510)
          numChans = 510;
        
        // Copy DMX data to the pixels buffer
        pixDriver.setBuffer(0, port * 510, artRDM.getDMX(group, port), numChans);
        
        // Output to pixel strip
        if (!syncEnabled)
          pixDone = false;

        return;

      // FX 12 Mode
      } else if (port == portA[1]) {
        byte* a = artRDM.getDMX(group, port);
        uint16_t s = deviceSettings.portApixFXstart - 1;
        
        pixFXA.Intensity = a[s + 0];
        pixFXA.setFX(a[s + 1]);
        pixFXA.setSpeed(a[s + 2]);
        pixFXA.Pos = a[s + 3];
        pixFXA.Size = a[s + 4];
        
        pixFXA.setColour1((a[s + 5] << 16) | (a[s + 6] << 8) | a[s + 7]);
        pixFXA.setColour2((a[s + 8] << 16) | (a[s + 9] << 8) | a[s + 10]);
        pixFXA.Size1 = a[s + 11];
        //pixFXA.Fade = a[s + 12];

        pixFXA.NewData = 1;
          
      }

    // DMX modes
    } else if (deviceSettings.portAmode != TYPE_DMX_IN && port == portA[1]) {
      dmxA.chanUpdate(numChans);
      
      #ifndef ESP_01
        setStatusLed(STATUS_LED_A, BLUE);
      #endif
    }
      

  #ifndef ONE_PORT
  } else if (portB[0] == group) {
    if (deviceSettings.portBmode == TYPE_WS2812) {
      setStatusLed(STATUS_LED_B, GREEN);
      
      if (deviceSettings.portBpixMode == FX_MODE_PIXEL_MAP) {
        if (numChans > 510)
          numChans = 510;
        
        // Copy DMX data to the pixels buffer
        pixDriver.setBuffer(1, port * 510, artRDM.getDMX(group, port), numChans);
        
        // Output to pixel strip
        if (!syncEnabled)
          pixDone = false;

        return;

      // FX 12 mode
      } else if (port == portB[1]) {
        byte* a = artRDM.getDMX(group, port);
        uint16_t s = deviceSettings.portBpixFXstart - 1;
        
        pixFXB.Intensity = a[s + 0];
        pixFXB.setFX(a[s + 1]);
        pixFXB.setSpeed(a[s + 2]);
        pixFXB.Pos = a[s + 3];
        pixFXB.Size = a[s + 4];
        pixFXB.setColour1((a[s + 5] << 16) | (a[s + 6] << 8) | a[s + 7]);
        pixFXB.setColour2((a[s + 8] << 16) | (a[s + 9] << 8) | a[s + 10]);
        pixFXB.Size1 = a[s + 11];
        //pixFXB.Fade = a[s + 12];

        pixFXB.NewData = 1;
      }
    } else if (deviceSettings.portBmode != TYPE_DMX_IN && port == portB[1]) {
      dmxB.chanUpdate(numChans);
      setStatusLed(STATUS_LED_B, BLUE);
    }
  #endif
  }

}

void syncHandle() {
  if (deviceSettings.portAmode == TYPE_WS2812) {
    rdmPause(1);
    pixDone = pixDriver.show();
    rdmPause(0);
  } else if (deviceSettings.portAmode != TYPE_DMX_IN)
    dmxA.unPause();

  #ifndef ONE_PORT
    if (deviceSettings.portBmode == TYPE_WS2812) {
      rdmPause(1);
      pixDone = pixDriver.show();
      rdmPause(0);
    } else if (deviceSettings.portBmode != TYPE_DMX_IN)
      dmxB.unPause();
  #endif
}

void ipHandle() {
  if (artRDM.getDHCP()) {
    deviceSettings.gateway = INADDR_NONE;
    
    deviceSettings.dhcpEnable = 1;
    doReboot = true;
    /*
    // Re-enable DHCP
    WiFi.begin(deviceSettings.wifiSSID, deviceSettings.wifiPass);

    // Wait for an IP
    while (WiFi.status() != WL_CONNECTED)
      yield();
    
    // Save settings to struct
    deviceSettings.ip = WiFi.localIP();
    deviceSettings.subnet = WiFi.subnetMask();
    deviceSettings.broadcast = {~deviceSettings.subnet[0] | (deviceSettings.ip[0] & deviceSettings.subnet[0]), ~deviceSettings.subnet[1] | (deviceSettings.ip[1] & deviceSettings.subnet[1]), ~deviceSettings.subnet[2] | (deviceSettings.ip[2] & deviceSettings.subnet[2]), ~deviceSettings.subnet[3] | (deviceSettings.ip[3] & deviceSettings.subnet[3])};

    // Pass IP to artRDM
    artRDM.setIP(deviceSettings.ip, deviceSettings.subnet);
    */
  
  } else {
    deviceSettings.ip = artRDM.getIP();
    deviceSettings.subnet = artRDM.getSubnetMask();
    deviceSettings.gateway = deviceSettings.ip;
    deviceSettings.gateway[3] = 1;
    deviceSettings.broadcast = {~deviceSettings.subnet[0] | (deviceSettings.ip[0] & deviceSettings.subnet[0]), ~deviceSettings.subnet[1] | (deviceSettings.ip[1] & deviceSettings.subnet[1]), ~deviceSettings.subnet[2] | (deviceSettings.ip[2] & deviceSettings.subnet[2]), ~deviceSettings.subnet[3] | (deviceSettings.ip[3] & deviceSettings.subnet[3])};
    deviceSettings.dhcpEnable = 0;
    
    doReboot = true;
    
    //WiFi.config(deviceSettings.ip,deviceSettings.ip,deviceSettings.ip,deviceSettings.subnet);
  }

  // Store everything to EEPROM
  eepromSave();
}

void addressHandle() {
  memcpy(&deviceSettings.nodeName, artRDM.getShortName(), ARTNET_SHORT_NAME_LENGTH);
  memcpy(&deviceSettings.longName, artRDM.getLongName(), ARTNET_LONG_NAME_LENGTH);
  
  deviceSettings.portAnet = artRDM.getNet(portA[0]);
  deviceSettings.portAsub = artRDM.getSubNet(portA[0]);
  deviceSettings.portAuni[0] = artRDM.getUni(portA[0], portA[1]);
  deviceSettings.portAmerge = artRDM.getMerge(portA[0], portA[1]);

  if (artRDM.getE131(portA[0], portA[1]))
    deviceSettings.portAprot = PROT_ARTNET_SACN;
  else
    deviceSettings.portAprot = PROT_ARTNET;


  #ifndef ONE_PORT
    deviceSettings.portBnet = artRDM.getNet(portB[0]);
    deviceSettings.portBsub = artRDM.getSubNet(portB[0]);
    deviceSettings.portBuni[0] = artRDM.getUni(portB[0], portB[1]);
    deviceSettings.portBmerge = artRDM.getMerge(portB[0], portB[1]);
    
    if (artRDM.getE131(portB[0], portB[1]))
      deviceSettings.portBprot = PROT_ARTNET_SACN;
    else
      deviceSettings.portBprot = PROT_ARTNET;
  #endif
  
  // Store everything to EEPROM
  eepromSave();
}

void rdmHandle(uint8_t group, uint8_t port, rdm_data* c) {
  if (portA[0] == group && portA[1] == port)
    dmxA.rdmSendCommand(c);

  #ifndef ONE_PORT
    else if (portB[0] == group && portB[1] == port)
      dmxB.rdmSendCommand(c);
  #endif
}

void rdmReceivedA(rdm_data* c) {
  artRDM.rdmResponse(c, portA[0], portA[1]);
}

void sendTodA() {
  artRDM.artTODData(portA[0], portA[1], dmxA.todMan(), dmxA.todDev(), dmxA.todCount(), dmxA.todStatus());
}

#ifndef ONE_PORT
void rdmReceivedB(rdm_data* c) {
  artRDM.rdmResponse(c, portB[0], portB[1]);
}

void sendTodB() {
  artRDM.artTODData(portB[0], portB[1], dmxB.todMan(), dmxB.todDev(), dmxB.todCount(), dmxB.todStatus());
}
#endif

void todRequest(uint8_t group, uint8_t port) {
  if (portA[0] == group && portA[1] == port)
    sendTodA();

  #ifndef ONE_PORT
    else if (portB[0] == group && portB[1] == port)
      sendTodB();
  #endif
}

void todFlush(uint8_t group, uint8_t port) {
  if (portA[0] == group && portA[1] == port)
    dmxA.rdmDiscovery();

  #ifndef ONE_PORT
    else if (portB[0] == group && portB[1] == port)
      dmxB.rdmDiscovery();
  #endif
}

void dmxIn(uint16_t num) {
  // Double buffer switch
  byte* tmp = dataIn;
  dataIn = dmxA.getChans();
  dmxA.setBuffer(tmp);
  
  newDmxIn = true;
}

void doStatusLedOutput() {
  uint8_t a[9] = {0, 0, 0, 0, 0, 0, 0, 0, 0};
  
  if (!statusLedsOff) {
    if (statusLedsDim) {
      for (uint8_t x = 0; x < 9; x++)
        a[x] = statusLedData[x] & STATUS_DIM;
    } else {
      for (uint8_t x = 0; x < 9; x++)
        a[x] = statusLedData[x];
    }
  }

  #ifdef STATUS_LED_MODE_APA106
    pixDriver.doAPA106(&a[0], STATUS_LED_PIN, 9);
  #endif

  #ifdef STATUS_LED_MODE_WS2812
    pixDriver.doPixel(&a[0], STATUS_LED_PIN, 9);
  #endif

  // Tint LEDs red slightly - they'll be changed back before being displayed if no errors
  for (uint8_t x = 1; x < 9; x += 3)
    statusLedData[x] = 125;
}

void setStatusLed(uint8_t num, uint32_t col) {
  memcpy(&statusLedData[num*3], &col, 3);
}
