mtongnz/ESP8266_ArtNetNode_v2/source/store.h

/*
ESP8266_ArtNetNode v2.0.0
Copyright (c) 2016, Matthew Tong
https://github.com/mtongnz/ESP8266_ArtNetNode_v2

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
This program is distributed in the hope that it will be useful, but WITHOUT ANY WARRANTY; without even the implied
warranty of MERCHANTABILITY or FITNESS FOR A PARTICULAR PURPOSE.  See the GNU General Public License for more details.
You should have received a copy of the GNU General Public License along with this program.
If not, see http://www.gnu.org/licenses/
*/


// Change this if the settings structure changes
#define CONFIG_VERSION "b5g"

// Dont change this
#define CONFIG_START 0

enum fx_mode {
  FX_MODE_PIXEL_MAP = 0,
  FX_MODE_12 = 1
};

enum p_type {
  TYPE_DMX_OUT = 0,
  TYPE_RDM_OUT = 1,
  TYPE_DMX_IN = 2,
  TYPE_WS2812 = 3
};

enum p_protocol {
  PROT_ARTNET = 0,
  PROT_ARTNET_SACN = 1
};

enum p_merge {
  MERGE_LTP = 0,
  MERGE_HTP = 1
};

struct StoreStruct {
  // StoreStruct version
  char version[4];

  // Device settings:
  IPAddress ip, subnet, gateway, broadcast, hotspotIp, hotspotSubnet, hotspotBroadcast, dmxInBroadcast;
  bool dhcpEnable, standAloneEnable;
  char nodeName[18], longName[64], wifiSSID[40], wifiPass[40], hotspotSSID[20], hotspotPass[20];
  uint16_t hotspotDelay;
  uint8_t portAmode, portBmode, portAprot, portBprot, portAmerge, portBmerge;
  uint8_t portAnet, portAsub, portAuni[4], portBnet, portBsub, portBuni[4], portAsACNuni[4], portBsACNuni[4];
  uint16_t portAnumPix, portBnumPix, portApixConfig, portBpixConfig;
  bool doFirmwareUpdate;
  uint8_t portApixMode, portBpixMode;
  uint16_t portApixFXstart, portBpixFXstart;
  uint8_t resetCounter, wdtCounter;
  
} deviceSettings = {
  CONFIG_VERSION,
  
  // The default values
  IPAddress(2,0,0,1), IPAddress(255,0,0,0), IPAddress(2,0,0,1), IPAddress(2,255,255,255), IPAddress(2,0,0,1), IPAddress(255,0,0,0), IPAddress(2,255,255,255), IPAddress(2,255,255,255),
  true, false,
  "espArtNetNode", "espArtNetNode by Matthew Tong", "", "", "espArtNetNode", "byMtongnz2017",
  15,
  TYPE_DMX_OUT, TYPE_DMX_OUT, PROT_ARTNET, PROT_ARTNET, MERGE_HTP, MERGE_HTP,
  0, 0, {0, 1, 2, 3}, 0, 0, {4, 5, 6, 7}, {1, 2, 3, 4}, {5, 6, 7, 8},
  680, 680, 0, 0,
  false,
  FX_MODE_PIXEL_MAP, FX_MODE_PIXEL_MAP,
  1, 1,
  0, 0
};


void eepromSave() {
  for (uint16_t t = 0; t < sizeof(deviceSettings); t++)
    EEPROM.write(CONFIG_START + t, *((char*)&deviceSettings + t));
  
  EEPROM.commit();
}

void eepromLoad() {
  // To make sure there are settings, and they are YOURS!
  // If nothing is found it will use the default settings.
  if (EEPROM.read(CONFIG_START + 0) == CONFIG_VERSION[0] &&
      EEPROM.read(CONFIG_START + 1) == CONFIG_VERSION[1] &&
      EEPROM.read(CONFIG_START + 2) == CONFIG_VERSION[2]) {

    // Store defaults for if we need them
    StoreStruct tmpStore;
    tmpStore = deviceSettings;
    
    // Copy data to deviceSettings structure
    for (uint16_t t = 0; t < sizeof(deviceSettings); t++)
      *((char*)&deviceSettings + t) = EEPROM.read(CONFIG_START + t);
    
    // If we want to restore all our settings
    if (deviceSettings.resetCounter >= 5 || deviceSettings.wdtCounter >= 10) {
      deviceSettings.wdtCounter = 0;
      deviceSettings.resetCounter = 0;

      // Store defaults back into main settings
      deviceSettings = tmpStore;
    }


  // If config files dont match, save defaults then erase the ESP config to clear away any residue
  } else {
    eepromSave();
    delay(500);
    
    ESP.eraseConfig();
    while(1);
  }
}
