mtongnz/ESP8266_ArtNetNode_v2/(commit log)

2017-02-09 Explain ESP01 wiring
    The ESP01 allows for one full DMX/RDM/Pixel port only. Use pin GPIO2 instead of GPIO5 for the RDM direction pin.
2017-02-11 Added button
    Added button to GPIO14 for resetting default values on startup & for future use to select scenes
2017-02-11 Add button_1
2017-02-19 Beta 5
    WS2812 timing refinements & allow interrupts during transmission
    Add DMX in feature
    Redo DMX library to have shorter interrupts to be compatible with the WS2812 output (max 3us interrupts)
    Added WDT reset catch - will boot without ports activated to allow changing settings - just for debug
    Added new settings reset method - reset the device (allow 1-4 seconds to boot) 5 times to restore default settings
2017-02-20 Added NodeMCU & Memos pin explanation
2017-02-21 Fix first LED flicker
    Fix the flicker on the first LED of each universe.
    This was caused by writing all 512 channels to the output buffer but only 510 (3*170) are actually used. This meant the last 2 channels of universe 1 would overwrite the first 2 for universe 2, causing a flicker or random colours.
2017-02-23 Beta 5b
    Partial fix for random ws2812 flashes.
    This flash is caused by a WiFi/system stack interrupt taking longer than 5us. This causes the ws2812 output to go low for too long, causing the ws2812 pixels to latch the data before it's all sent.
    I have partially fixed this by disabling interrupts during ws2812 output, except when there is DMX also running as the DMX requires interrupts.
2017-02-27 Beta5c
    * Delete espArtnetNode_2.0.0_b5b.bin
    * Delete espArtnetNode_2.0.0_b5b_ESP01.bin
    * Delete espArtnetNode_2.0.0_b5b_NO_RESET.bin
    * Delete espArtnetNode_2.0.0_b5b_WEMOS.bin
    * beta5c
    Added gateway option
    Added ability to use a custom CSS style sheet
    Changed the way IP address change are handled. Device now resets to ensure everything is set correctly
    * Update README.md
2017-06-11 beta5g
    Minor fixes & updates. Split code into separate file for easier reading. Added status LEDs
    [ajax.ino, espArtnetNode_2.0.0_b5g.ino, firmUpdate.ino, startFunctions.ino, store.h, ws2812Driver.cpp, ws2812Driver.h, wsFX.cpp]
2018-03-25 Added BOM
    Added bill of materials for RDM isolated schematic
